RepRapLtd/AnalogueNeuralNet/Electronics/gpt4-maybe-halucinating.odt

To set up the AD5628 DAC for operation and ensure you can use Command 0x03 to write voltages directly to all eight channels, you’ll need to configure it properly through SPI. The AD5628 accepts 32-bit data packets with each packet structured as follows:

1. Control Bits (4 bits): These specify the command or operation.
2. Address Bits (4 bits): These specify the DAC channel (or channels, in the case of broadcast and other functions) being addressed.
3. Data Bits (24 bits): These carry the actual data for the DAC to convert or use in other operations.

Here is the recommended sequence of commands to set up the AD5628 for subsequent use with command 0x03 to directly write voltages:

### 1. Reset the Device

Before any configuration, it’s good practice to reset the DAC:

- Command (4 bits): 0x04 (Reset command)
- Address (4 bits): 0xF (all channels)
- Data (24 bits): All zeros 0x000000

SPI Packet: 0x4F000000

### 2. Power-Up All DACs

You might want to ensure all DAC channels are powered up:

- Command (4 bits): 0x02 (Power up/down)
- Address (4 bits): 0xF (all channels)
- Data (24 bits): Lower 8 bits set to 0x01 to power up, rest are 0s (0x01 for each channel you want powered up)

SPI Packet: 0x2F000001

### 3. Set Internal Reference (if not using an external reference)

To use the internal reference:

- Command (4 bits): 0x07 (Internal reference setup)
- Address (4 bits): 0xF (all channels)
- Data (24 bits): First bit 1 to enable, rest are 0s

SPI Packet: 0x7F800000

### Using Command 0x03 to Write to DAC Channels

Now that the DAC is configured, you can write voltages to any of the eight channels using command 0x03:

- Command (4 bits): 0x03 (Write and update DAC channel)
- Address (4 bits): 0xX (choose from 0 to 7 to specify the channel)
- Data (24 bits): Data to be written to the specified DAC

SPI Packet Example (writing to channel 0):

- Data: 0x03, Address: 0x0, Data: Let's say half-scale (0x7FFFFF for 24-bit DAC)
- SPI Packet: 0x3007FFFF

For each channel, adjust the address bits accordingly (0x0 to 0x7) and specify your desired output value in the data field. Remember, the data resolution and reference voltage determine the output voltage value.

Always ensure that your SPI settings (clock polarity, phase, and maximum frequency) comply with the AD5628 specifications. Also, verify all SPI transactions with oscilloscope traces or logic analyzers to confirm that the timing and data integrity meet the requirements of the AD5628. This methodical setup should ensure smooth operation of the DAC for precision output tasks.
