RepRapLtd/AnalogueNeuralNet/Documents/1.27-socket.pdf

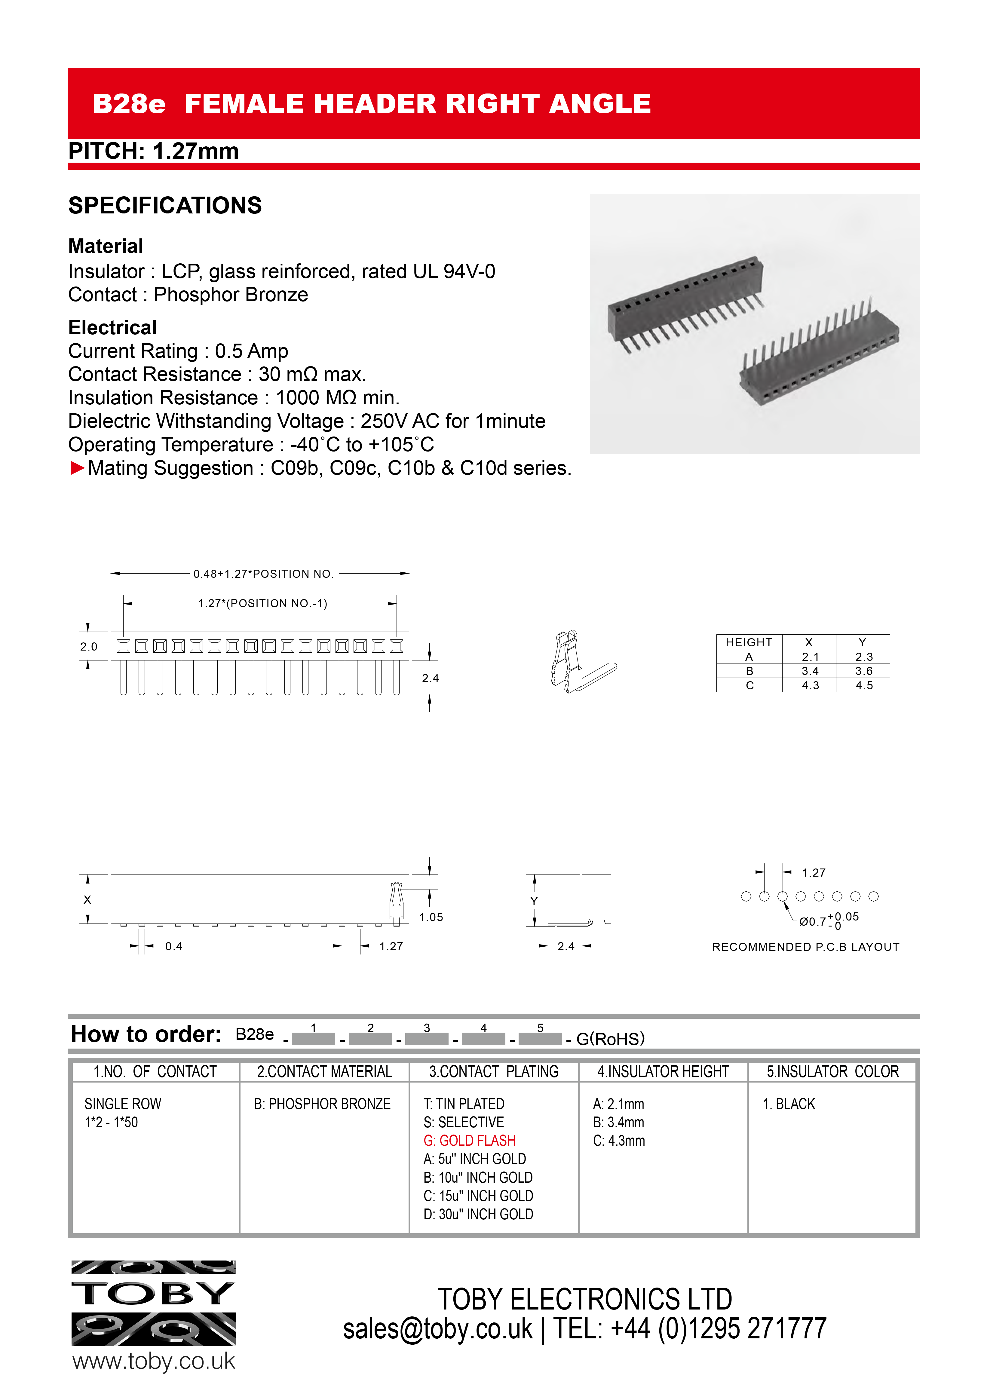
[picture p5: page 1]
