RepRapLtd/AnalogueNeuralNet/Documents/holographic-ann.pdf

© 1990 NaturePublishingGroup

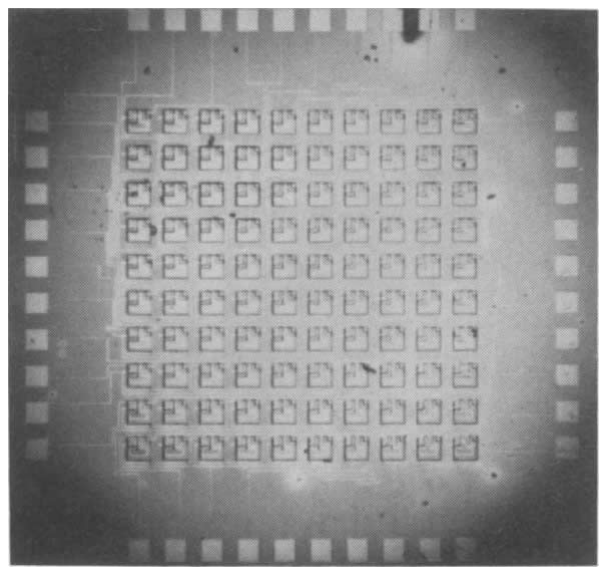
[picture p6: figure]

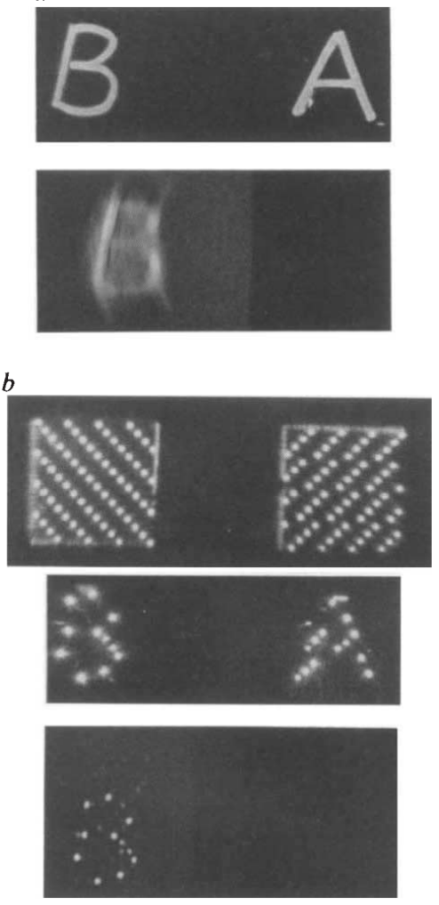
[picture p7: figure]
