RepRapLtd/AnalogueNeuralNet/Electronics/op-amp-bias.ods

r1 | 330
r2 | 182.032258064516
lpr | 33
v | 1.3671875
Vcc | 5
 | 1.3671875
