RepRapLtd/AnalogueNeuralNet/Electronics/one-synapse-electronic-A/one-synapse-electronic/one-synapse-electronic.ods

 | /home/ensab/Desktop/rrlOwncloud/RepRapLtd/Engineering/Internal-Projects/AnalogueNeuralNet/Electronics/one-synapse-electronic/one-synapse-electronic/one-synapse-electronic.kicad_sch
Date: | Fri Nov 10 15:12:36 2023
Tool: | Eeschema 7.0.8-7.0.8~ubuntu20.04.1
Generator: | /usr/share/kicad/plugins/bom_csv_grouped_by_value.py
Component Count: | 141
Collated Components:
Item | Qty | Value | LibPart | Footprint | Datasheet | DNP
1 | 6 | 0.1uF | Device:C | Capacitor_SMD:C_0805_2012Metric | ~
2 | 16 | 120nF | Device:C | Capacitor_SMD:C_0805_2012Metric | ~
3 | 1 | 10uF | Device:C_Polarized | Capacitor_THT:CP_Radial_D8.0mm_P2.50mm | ~
4 | 1 | LED | Device:LED | LED_SMD:LED_0805_2012Metric_Pad1.15x1.40mm_HandSolder | ~
5 | 4 | MountingHole | Mechanical:MountingHole | MountingHole:MountingHole_2.5mm | ~
6 | 1 | prg-err | Connector:Conn_01x02_Pin | Connector_PinHeader_2.54mm:PinHeader_1x02_P2.54mm_Vertical | ~
7 | 2 | Axon | Connector:Conn_01x08_Socket | Connector_PinSocket_2.54mm:PinSocket_1x08_P2.54mm_Vertical | ~
8 | 1 | PWM-in | Connector:Conn_01x07_Pin | Connector_PinHeader_2.54mm:PinHeader_1x07_P2.54mm_Horizontal | ~
9 | 1 | PWM-out | Connector:Conn_01x07_Socket | Connector_PinSocket_2.54mm:PinSocket_1x07_P2.54mm_Horizontal | ~
10 | 1 | pwr | Connector:Conn_01x02_Pin | Connector_PinHeader_2.54mm:PinHeader_1x02_P2.54mm_Vertical | ~
11 | 1 | synapses | Connector:Conn_01x08_Socket | Connector_PinHeader_2.54mm:PinHeader_1x08_P2.54mm_Vertical | ~
12 | 1 | sel | Connector:Conn_01x04_Socket | Connector_PinSocket_2.54mm:PinSocket_1x04_P2.54mm_Vertical | ~
13 | 1 | comb | Connector:Conn_01x03_Socket | Connector_PinSocket_2.54mm:PinSocket_1x03_P2.54mm_Vertical | ~
14 | 1 | sj | Jumper:SolderJumper_2_Bridged | Jumper:SolderJumper-2_P1.3mm_Bridged2Bar_Pad1.0x1.5mm | ~
15 | 17 | BS170F | Transistor_FET:BS170F | Package_TO_SOT_SMD:SOT-23 | http://www.diodes.com/assets/Datasheets/BS170F.pdf
16 | 1 | 2K2 | Device:R | Resistor_SMD:R_0805_2012Metric | ~
17 | 16 | 47K | Device:R | Resistor_SMD:R_0805_2012Metric | ~
18 | 9 | 10K | Device:R | Resistor_SMD:R_0805_2012Metric | ~
19 | 8 | 1M | Device:R | Resistor_SMD:R_0805_2012Metric | ~
20 | 17 | 220R | Device:R | Resistor_SMD:R_0805_2012Metric | ~
21 | 9 | 22K | Device:R | Resistor_SMD:R_0805_2012Metric | ~
22 | 8 | 470K | Device:R | Resistor_SMD:R_0805_2012Metric | ~
23 | 10 | 220K | Device:R | Resistor_SMD:R_0805_2012Metric | ~
24 | 2 | 100K | Device:R | Resistor_SMD:R_0805_2012Metric | ~
25 | 1 | TLC5940PWP | Driver_LED:TLC5940PWP | Package_SO:HTSSOP-28-1EP_4.4x9.7mm_P0.65mm_EP3.4x9.5mm_Mask2.4x6.17mm_ThermalVias | http://www.ti.com/lit/ds/symlink/tlc5940.pdf
26 | 5 | MCP6004 | Amplifier_Operational:MCP6004 | Package_SO:HTSSOP-14-1EP_4.4x5mm_P0.65mm_EP3.4x5mm_Mask3x3.1mm | http://ww1.microchip.com/downloads/en/DeviceDoc/21733j.pdf
