RepRapLtd/AnalogueNeuralNet/Electronics/Kicad/ADG2188BCPZ-REEL7.step

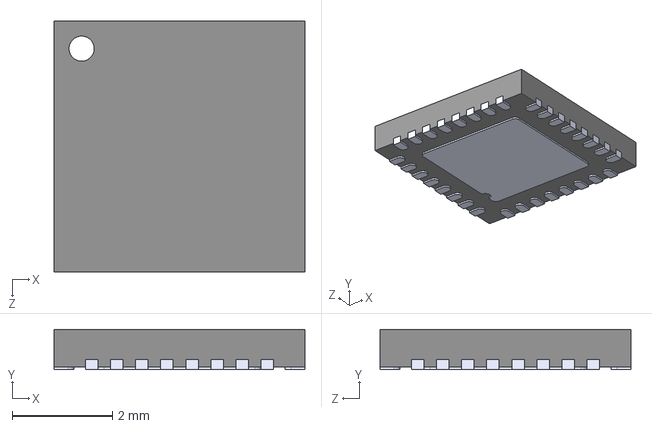
[picture p8: CAD file, 2024-05-18]
Electronics/Kicad/ADG2188BCPZ-REEL7.step
5.00 x 0.8 x 5.00 mm
