RepRapLtd/AnalogueNeuralNet/Mechanics/laser-dot-test.dxf

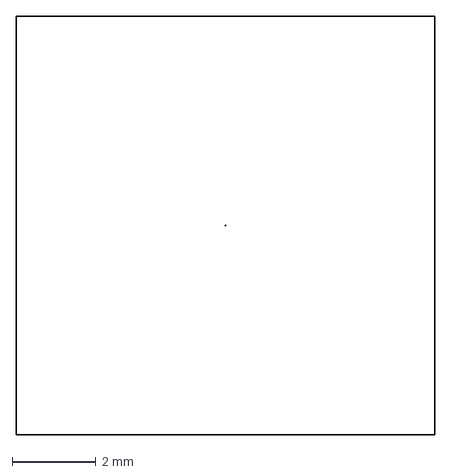
[picture p9: CAD file, 2021-03-25]
Mechanics/laser-dot-test.dxf
10.0 x 10.0 mm
