RepRapLtd/AnalogueNeuralNet/Mechanics/STL/Painting Jig 0.1.stl

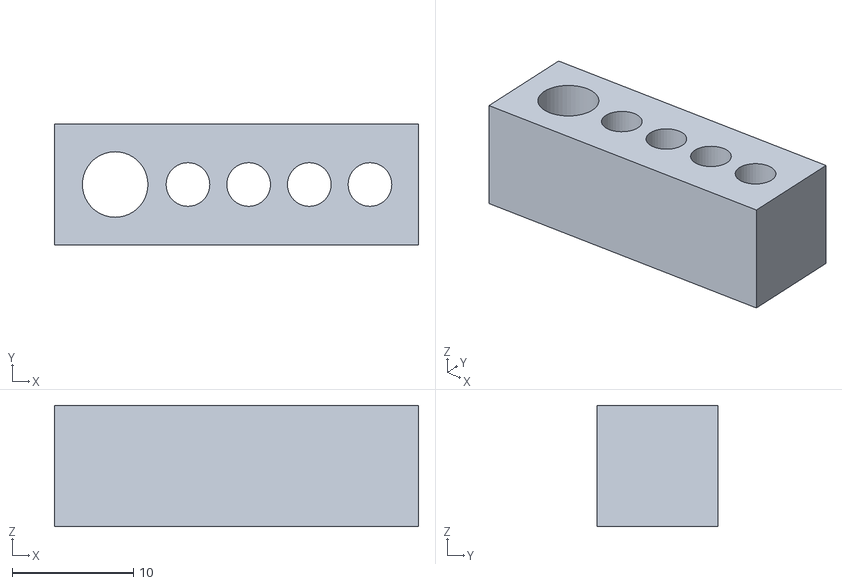
[picture p10: CAD file, 2020-11-20]
Mechanics/STL/Painting Jig 0.1.stl
30.0 x 10.0 x 10.0
