RepRapLtd/AnalogueNeuralNet/Optics/laser-rectangle-100x20.dxf

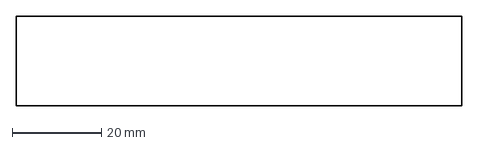
[picture p11: CAD file, 2021-03-05]
Optics/laser-rectangle-100x20.dxf
100.0 x 20.0 mm
