RepRapLtd/AnalogueNeuralNet/Mechanics/integrated-neuron-0.2.FCStd

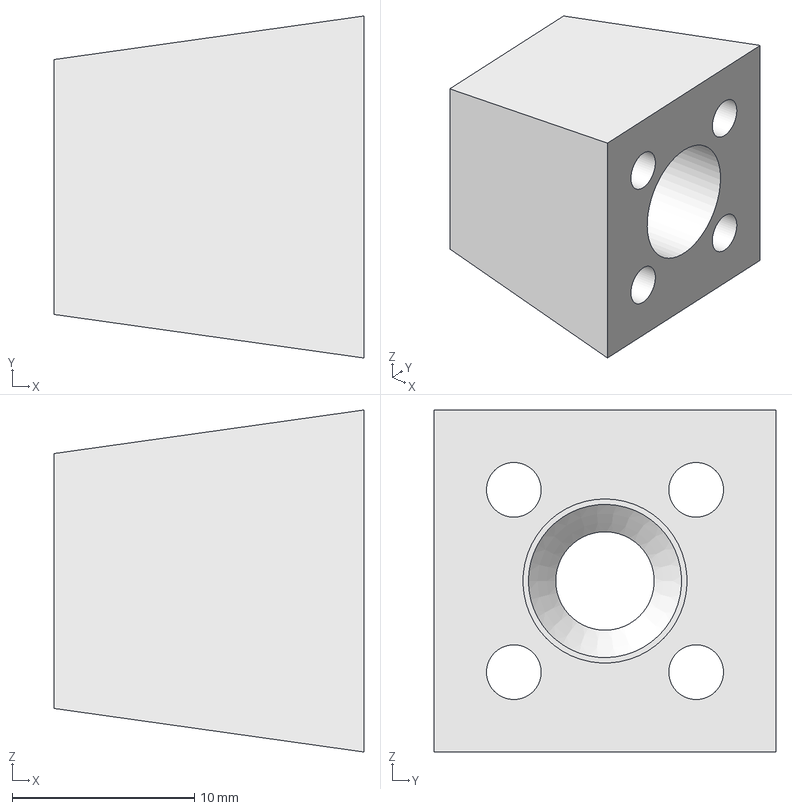
[picture p12: CAD file, 2021-01-26]
Mechanics/integrated-neuron-0.2.FCStd
17.0 x 18.8 x 18.8 mm
