RepRapLtd/AnalogueNeuralNet/Mechanics/STL/integrated-neuron-output.stl

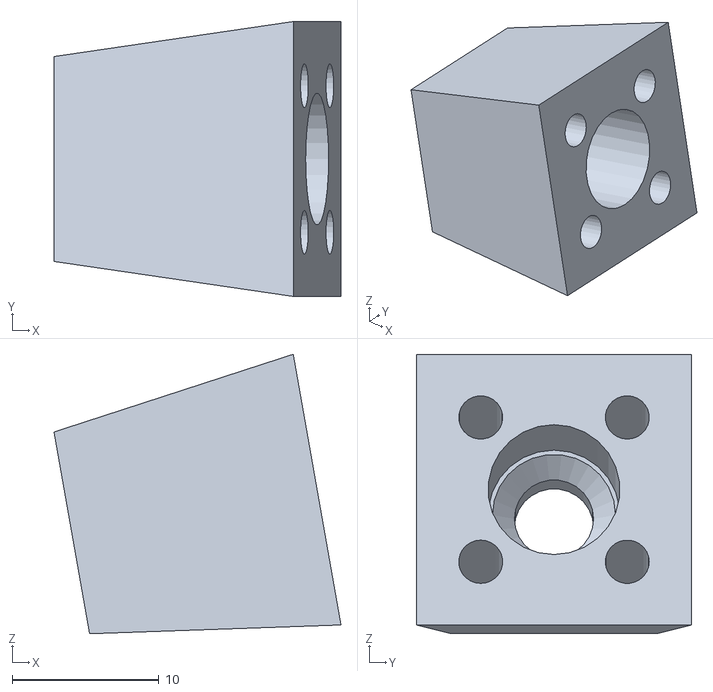
[picture p13: CAD file, 2020-11-06]
Mechanics/STL/integrated-neuron-output.stl
19.6 x 18.8 x 19.1
