RepRapLtd/AnalogueNeuralNet/Mechanics/Crude Image Sensor Array 0.1.FCStd

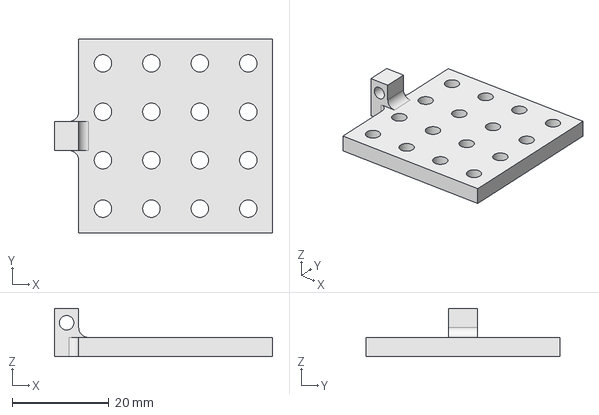
[picture p14: CAD file, 2020-12-15]
Mechanics/Crude Image Sensor Array 0.1.FCStd
45.0 x 40.0 x 10.0 mm
