RepRapLtd/AnalogueNeuralNet/Mechanics/STL/integrated-neuron-fibres.stl

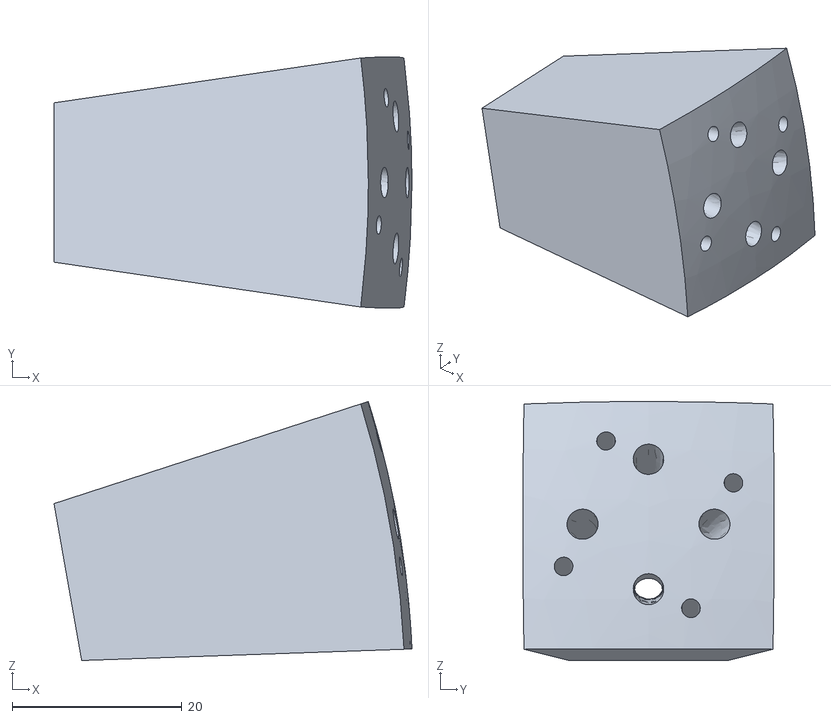
[picture p15: CAD file, 2020-11-06]
Mechanics/STL/integrated-neuron-fibres.stl
42.2 x 29.6 x 30.5
