RepRapLtd/AnalogueNeuralNet/Mechanics/neuron-diagram.dxf

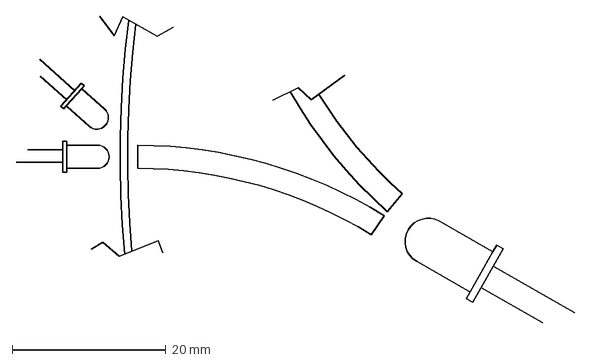
[picture p16: CAD file, 2020-11-27]
Mechanics/neuron-diagram.dxf
72.7 x 39.9 mm
