RepRapLtd/AnalogueNeuralNet/Mechanics/STL/integrated-neuron-input.stl

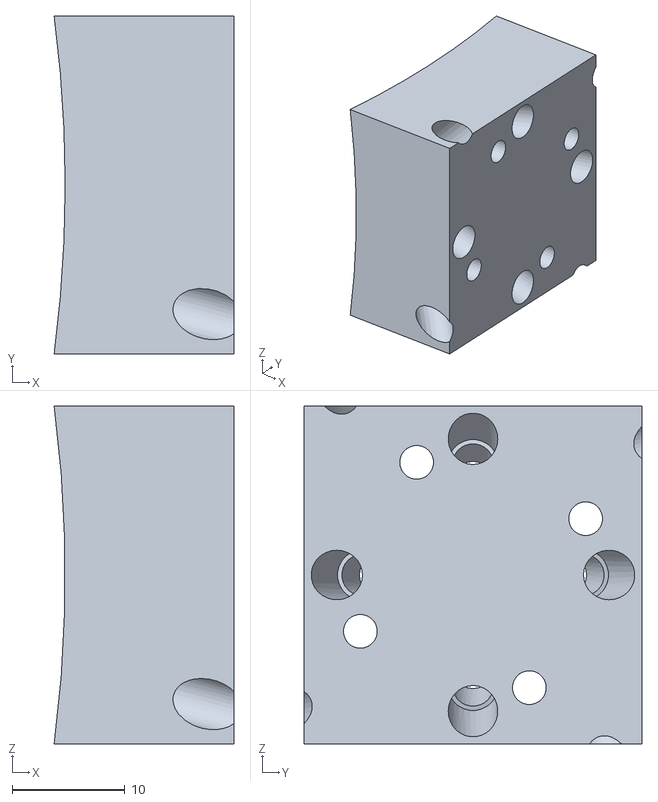
[picture p17: CAD file, 2020-11-06]
Mechanics/STL/integrated-neuron-input.stl
16.0 x 30.0 x 30.0
