RepRapLtd/AnalogueNeuralNet/Mechanics/Painting Jig 0.2 (ultimaker).FCStd

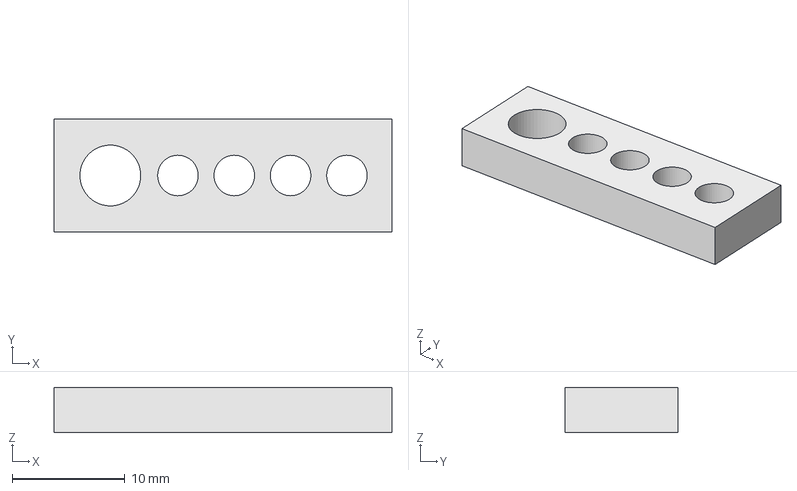
[picture p18: CAD file, 2020-11-26]
Mechanics/Painting Jig 0.2 (ultimaker).FCStd
30.0 x 10.0 x 4.00 mm
