RepRapLtd/AnalogueNeuralNet/Mechanics/STL/light-input.stl

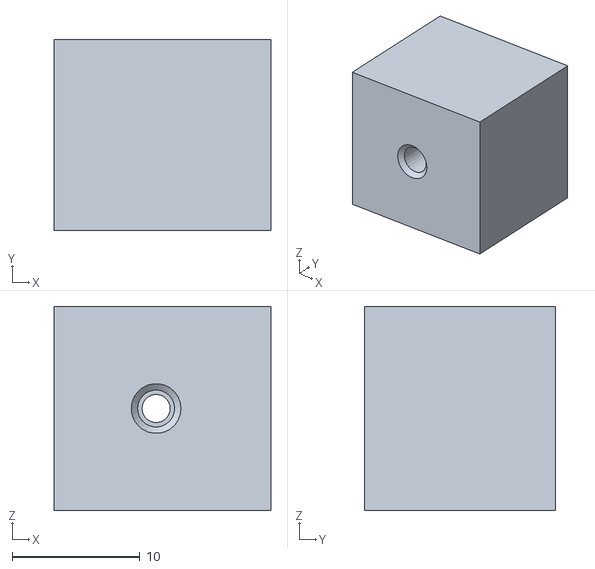
[picture p19: CAD file, 2020-10-22]
Mechanics/STL/light-input.stl
17.0 x 15.0 x 16.0
