RepRapLtd/AnalogueNeuralNet/Mechanics/Sanding Disc 0.1.FCStd

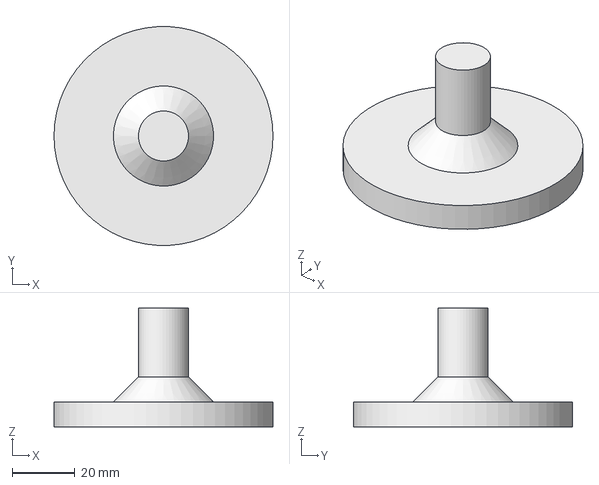
[picture p20: CAD file, 2020-11-24]
Mechanics/Sanding Disc 0.1.FCStd
70.0 x 69.9 x 38.0 mm
