RepRapLtd/AnalogueNeuralNet/Mechanics/STL/synapse.stl

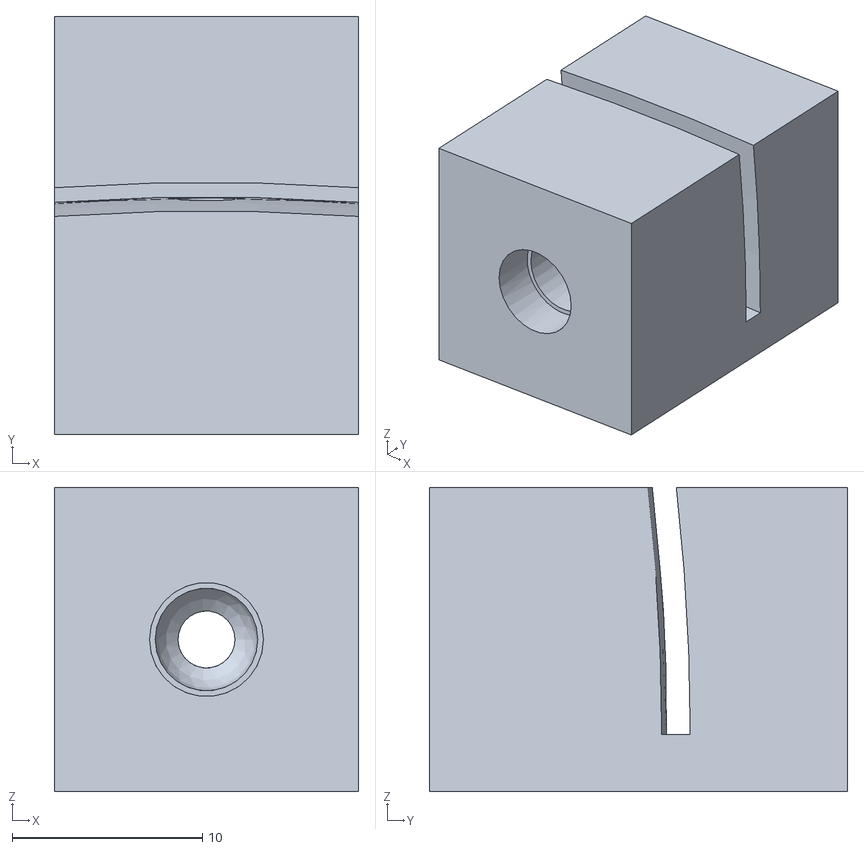
[picture p21: CAD file, 2020-10-21]
Mechanics/STL/synapse.stl
16.0 x 22.0 x 16.0
