RepRapLtd/AnalogueNeuralNet/Mechanics/Painting Jig 0.1 (Fisher).FCStd

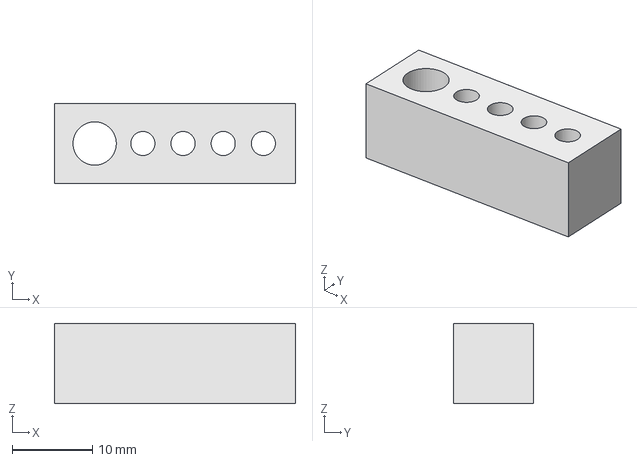
[picture p22: CAD file, 2020-11-24]
Mechanics/Painting Jig 0.1 (Fisher).FCStd
30.0 x 10.0 x 10.0 mm
