RepRapLtd/AnalogueNeuralNet/Mechanics/integrated-neuron-0.1.FCStd

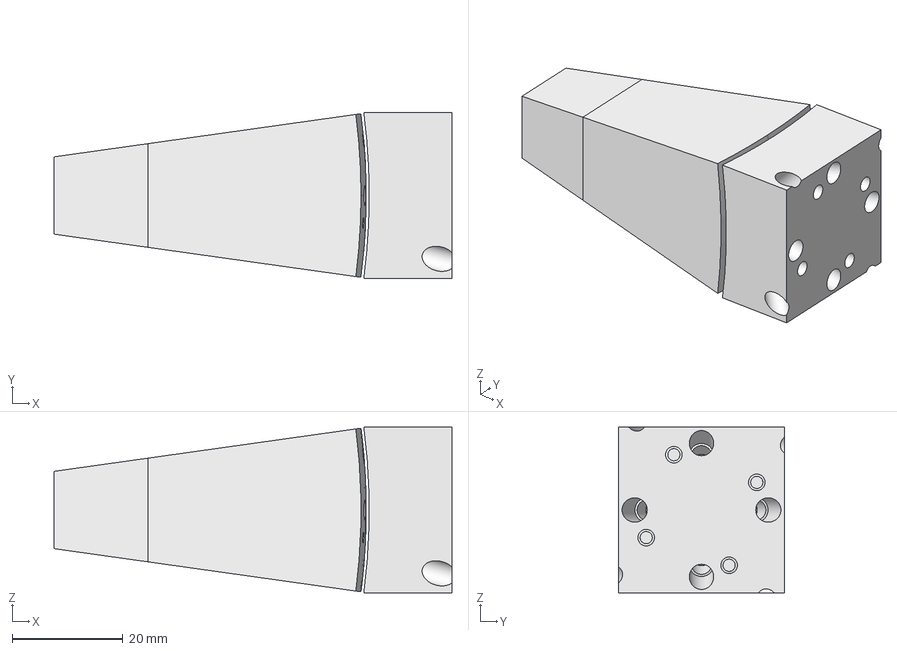
[picture p23: CAD file, 2020-11-06]
Mechanics/integrated-neuron-0.1.FCStd
72.0 x 30.0 x 30.0 mm
light-fibres
input
output
