RepRapLtd/AnalogueNeuralNet/Mechanics/Synapse 2 Small LED 0.1.FCStd

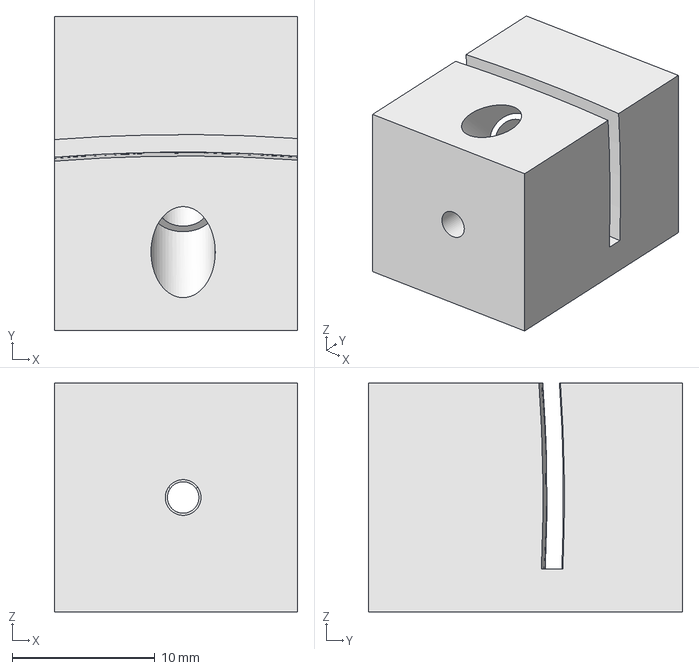
[picture p24: CAD file, 2020-11-03]
Mechanics/Synapse 2 Small LED 0.1.FCStd
17.0 x 22.0 x 16.0 mm
