RepRapLtd/AnalogueNeuralNet/Mechanics/Light Input 0.2.FCStd

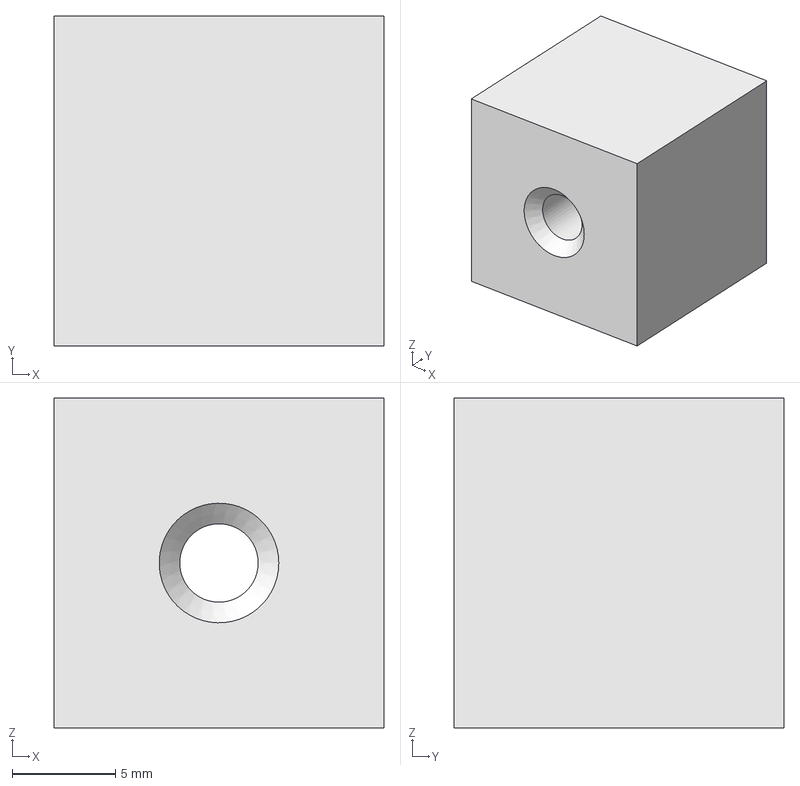
[picture p25: CAD file, 2020-11-03]
Mechanics/Light Input 0.2.FCStd
16.0 x 16.0 x 16.0 mm
