RepRapLtd/AnalogueNeuralNet/Mechanics/Multi Input Synapse 0.1.FCStd

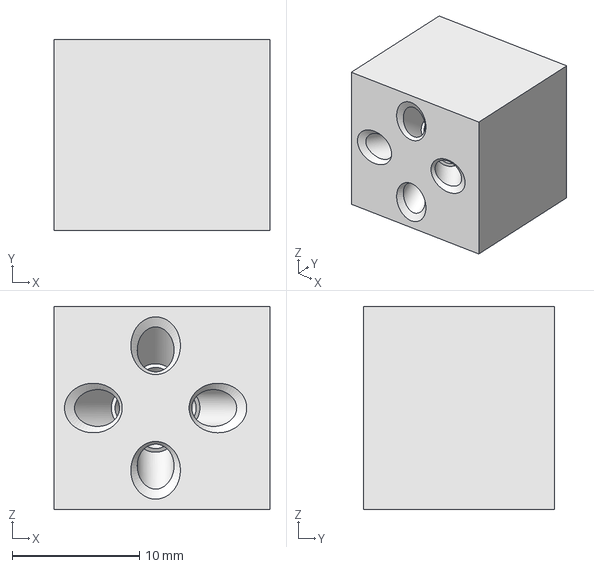
[picture p26: CAD file, 2020-10-22]
Mechanics/Multi Input Synapse 0.1.FCStd
17.0 x 15.0 x 16.0 mm
