RepRapLtd/AnalogueNeuralNet/Mechanics/Synapse 2 0.1.FCStd

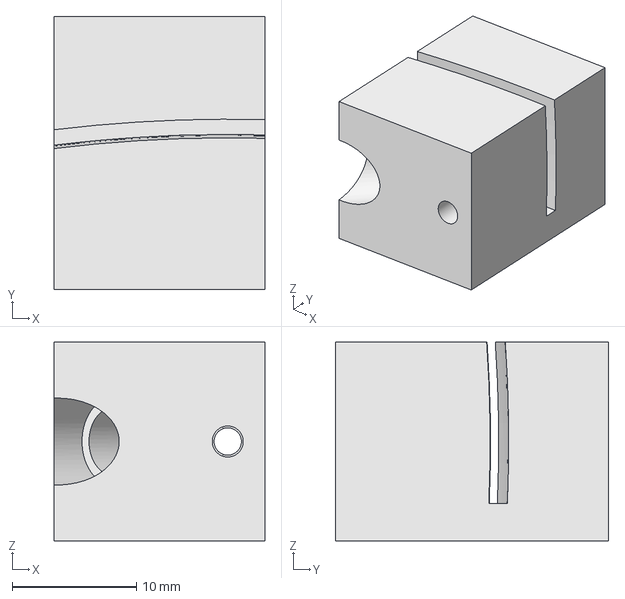
[picture p27: CAD file, 2020-10-22]
Mechanics/Synapse 2 0.1.FCStd
17.0 x 22.0 x 16.0 mm
