RepRapLtd/AnalogueNeuralNet/(list of files, cad)

Other CAD files:
Mechanics/Painting Jig 0.1 (ultimaker).FCStd
Mechanics/Synapse 2 Small LED 0.2.FCStd
Mechanics/Light Input 0.1.FCStd
Mechanics/single-synapse.FCStd
Mechanics/STL/Crude Image Sensor Array 0.1.stl
Mechanics/STL/Light Input 0.2.stl
Mechanics/STL/Multi Input Synapse 0.1.stl
Mechanics/STL/Painting Jig 0.2(Ultimaker).stl
Mechanics/STL/Sanding Disc 0.1.stl
Mechanics/STL/Synapse 2 0.1.stl
Mechanics/STL/Synapse 2 Small LED 0.1.stl
Mechanics/STL/Synapse 2 Small LED 0.2.stl
