RepRapLtd/AnalogueNeuralNet/Experiments/first-teaching-results.txt

Seems to be oscillating...

RepRap Ltd Optical Half-Neuron Starting
2 mins
0.37, 19, 21, 24, 24, 2, -3, 2, -3
0.37, 21, 18, 26, 21, -5, 7, -5, 7
0.25, 16, 25, 21, 28, 19, -28, 19, -28
0.37, 35, 0, 40, 0, -51, 66, -51, 74
0.19, 0, 66, 0, 74, 186, -352, 212, -395
