RepRapLtd/AnalogueNeuralNet/Experiments/MCP604-driving-LED.ods

Vin | Vout | Iout (mA)
0 | 0.1 | 0
1.67 | 1.648 | 0.01
1.81 | 1.789 | 0.09
1.85 | 1.828 | 0.15
1.95 | 1.926 | 0.39
2.07 | 2.052 | 0.79
2.2 | 2.179 | 1.25
2.31 | 2.286 | 1.65
2.42 | 2.4 | 2.09
2.63 | 2.607 | 2.89
2.79 | 2.765 | 3.53
3.02 | 2.992 | 4.46
3.24 | 3.206 | 5.33
3.61 | 3.58 | 6.88
3.93 | 3.89 | 8.17
4.32 | 4.27 | 9.79
4.56 | 4.51 | 10.8
4.88 | 4.83 | 12.16
4.94 | 5.5 | 12.4
