RepRapLtd/AnalogueNeuralNet/Experiments/Driven-LED-calibration.ods

PWM | 300, 1ms | 1000,1ms | 100,1ms | 100,0ms | bias resistors; no fibre
0 | 5 | 5 | 5 | 5 | 5
1 | 4.99 | 4.99 | 5 | 5 | 5
2 | 5 | 4.99 | 5 | 5 | 5
3 | 5 | 5 | 5 | 5 | 4.99
4 | 5 | 5 | 5 | 5 | 5
5 | 5 | 5 | 5 | 4.99 | 5
6 | 5 | 5 | 5 | 5 | 5
7 | 5 | 5 | 5 | 5 | 5
8 | 5 | 5 | 5 | 5 | 5
9 | 5 | 5 | 5 | 5 | 5
10 | 5 | 5 | 5 | 5 | 5
11 | 5 | 5 | 5 | 5 | 5
12 | 5 | 5 | 4.99 | 5 | 4.99
13 | 5 | 5 | 5 | 5 | 4.98
14 | 5 | 5 | 5 | 5 | 4.95
15 | 5 | 5 | 5 | 5 | 4.89
16 | 5 | 5 | 5 | 5 | 4.87
17 | 5 | 5 | 5 | 5 | 4.85
18 | 4.99 | 5 | 5 | 5 | 4.83
19 | 5 | 5 | 5 | 4.99 | 4.81
20 | 4.99 | 5 | 5 | 5 | 4.79
21 | 5 | 5 | 5 | 5 | 4.77
22 | 5 | 5 | 5 | 5 | 4.74
23 | 5 | 5 | 5 | 4.99 | 4.73
24 | 5 | 5 | 5 | 5 | 4.71
25 | 5 | 5 | 5 | 5 | 4.69
26 | 5 | 5 | 5 | 5 | 4.67
27 | 5 | 5 | 5 | 5 | 4.65
28 | 5 | 5 | 5 | 4.99 | 4.63
29 | 4.99 | 5 | 5 | 5 | 4.61
30 | 5 | 5 | 4.99 | 5 | 4.59
31 | 5 | 5 | 5 | 5 | 4.57
32 | 5 | 5 | 5 | 5 | 4.55
33 | 5 | 5 | 5 | 5 | 4.52
34 | 5 | 5 | 5 | 4.99 | 4.51
35 | 5 | 5 | 5 | 5 | 4.49
36 | 5 | 5 | 5 | 5 | 4.46
37 | 5 | 5 | 5 | 5 | 4.44
38 | 5 | 5 | 5 | 5 | 4.42
39 | 5 | 5 | 5 | 5 | 4.4
40 | 5 | 5 | 5 | 5 | 4.37
41 | 5 | 5 | 5 | 5 | 4.36
42 | 5 | 5 | 5 | 5 | 4.33
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
