RepRapLtd/AnalogueNeuralNet/Experiments/half-neuron-calibration.ods

Sheet: real-half-neuron-calibration
 | PWM |  |  |  | 0 | 1 | 2 | 3 | 4 | 5 | 6 | 7 | 8 | 9 | 10 | 11 | 12 | 13 | 14 | 15 | simulation | 1 | 2 | 4 | 8
0 | 0 | 0 | 0 | 0 | 5 | 4.38 | 4.27 | 3.63 | 4.53 | 3.89 | 3.77 | 3.12 | 4.46 | 3.82 | 3.71 | 3.06 | 3.98 | 3.33 | 3.21 | 2.55 | 2.6 | 4.38 | 4.27 | 4.53 | 4.46
1 | 17 | 0 | 0 | 0 | 5 | 4.62 | 4.27 | 3.87 | 4.53 | 4.13 | 3.77 | 3.37 | 4.46 | 4.06 | 3.71 | 3.3 | 3.98 | 3.57 | 3.21 | 2.8 | 2.84 | 4.62 | 4.51 | 4.63 | 4.62
2 | 34 | 0 | 0 | 0 | 5 | 4.68 | 4.27 | 3.94 | 4.53 | 4.19 | 3.77 | 3.43 | 4.46 | 4.13 | 3.71 | 3.36 | 3.98 | 3.64 | 3.21 | 2.87 | 2.9 | 4.68 | 4.58 | 4.67 | 4.67
3 | 51 | 0 | 0 | 0 | 5 | 4.71 | 4.27 | 3.96 | 4.53 | 4.22 | 3.77 | 3.46 | 4.46 | 4.16 | 3.71 | 3.4 | 3.98 | 3.67 | 3.21 | 2.9 | 2.93 | 4.71 | 4.62 | 4.71 | 4.7
4 | 68 | 0 | 0 | 0 | 5 | 4.73 | 4.27 | 3.98 | 4.53 | 4.24 | 3.77 | 3.48 | 4.46 | 4.18 | 3.71 | 3.41 | 3.98 | 3.69 | 3.21 | 2.92 | 2.95 | 4.73 | 4.64 | 4.72 | 4.71
5 | 85 | 0 | 0 | 0 | 5 | 4.74 | 4.27 | 3.99 | 4.53 | 4.25 | 3.77 | 3.49 | 4.46 | 4.19 | 3.71 | 3.43 | 3.98 | 3.7 | 3.21 | 2.93 | 2.96 | 4.74 | 4.66 | 4.74 | 4.73
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
