RepRapLtd/AnalogueNeuralNet/Experiments/pwm-test.ods

seconds | PWM=63 | PWM=127 | PWM=191 | PWM=255
1 | 3.24 | 3.22 | 3.2 | 3.15
2 | 3.24 | 3.2 | 3.2 | 3.15
3 | 3.24 | 3.24 | 3.24 | 3.2
4 | 3.25 | 3.26 | 3.27 | 3.26
5 | 3.26 | 3.29 | 3.33 | 3.31
6 | 3.27 | 3.32 | 3.35 | 3.36
7 | 3.29 | 3.34 | 3.39 | 3.4
8 | 3.3 | 3.37 | 3.42 | 3.44
9 | 3.32 | 3.39 | 3.46 | 3.48
10 | 3.33 | 3.41 | 3.48 | 3.51
11 | 3.34 | 3.43 | 3.51 | 3.54
12 | 3.35 | 3.45 | 3.54 | 3.56
13 | 3.36 | 3.46 | 3.55 | 3.59
14 | 3.37 | 3.49 | 3.58 | 3.61
15 | 3.39 | 3.51 | 3.6 | 3.63
16 | 3.4 | 3.52 | 3.61 | 3.66
17 | 3.41 | 3.54 | 3.64 | 3.67
18 | 3.42 | 3.55 | 3.65 | 3.69
19 | 3.43 | 3.57 | 3.67 | 3.71
20 | 3.43 | 3.57 | 3.68 | 3.73
21 | 3.45 | 3.59 | 3.7 | 3.74
22 | 3.45 | 3.6 | 3.71 | 3.75
23 | 3.47 | 3.61 | 3.72 | 3.76
24 | 3.47 | 3.62 | 3.74 | 3.77
25 | 3.48 | 3.63 | 3.75 | 3.78
26 | 3.49 | 3.65 | 3.76 | 3.79
27 | 3.49 | 3.65 | 3.76 | 3.81
28 | 3.5 | 3.66 | 3.77 | 3.81
29 | 3.52 | 3.67 | 3.78 | 3.83
30 | 3.53 | 3.68 | 3.79 | 3.83
31 | 3.53 | 3.69 | 3.8 | 3.84
32 | 3.54 | 3.7 | 3.81 | 3.85
33 | 3.54 | 3.71 | 3.82 | 3.86
34 | 3.56 | 3.71 | 3.83 | 3.86
35 | 3.55 | 3.73 | 3.84 | 3.87
36 | 3.56 | 3.73 | 3.84 | 3.87
37 | 3.56 | 3.75 | 3.84 | 3.88
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
