RepRapLtd/AnalogueNeuralNet/Experiments/half-neuron-individual-input-characteristics.png

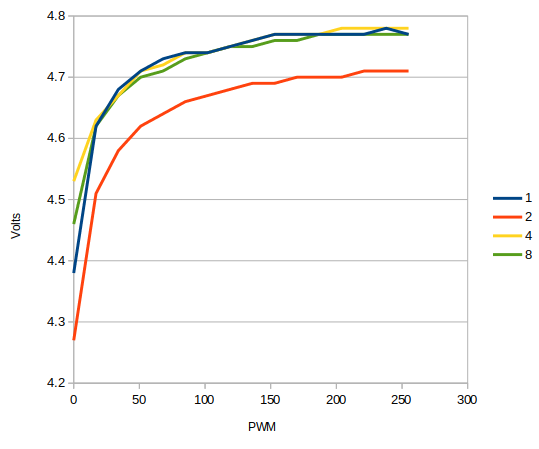
Experiments/half-neuron-individual-input-characteristics.png
