RepRapLtd/AnalogueNeuralNet/Experiments/on-off-response.png

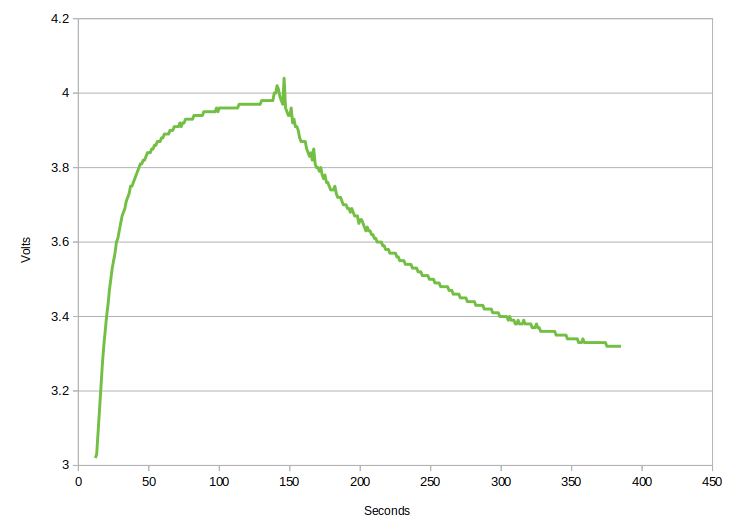
Experiments/on-off-response.png
