RepRapLtd/AnalogueNeuralNet/Electronics/one-synapse-electronic-B/one-synapse-electronic-B/universal-building-block.pdf

R12 R1

# GND GND

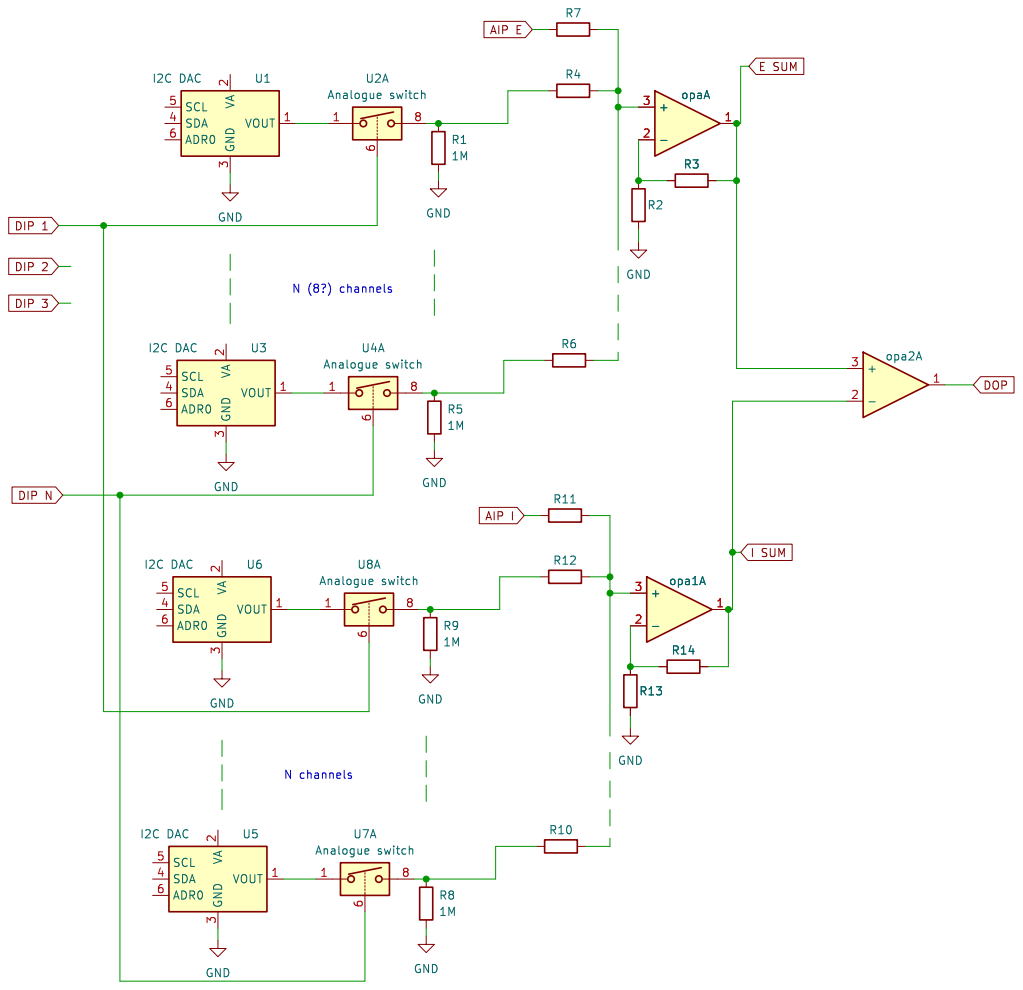
[picture p30: page 1]
