RepRapLtd/AnalogueNeuralNet/Documents/SparkFun-TLC5940-Breakout-v12.pdf

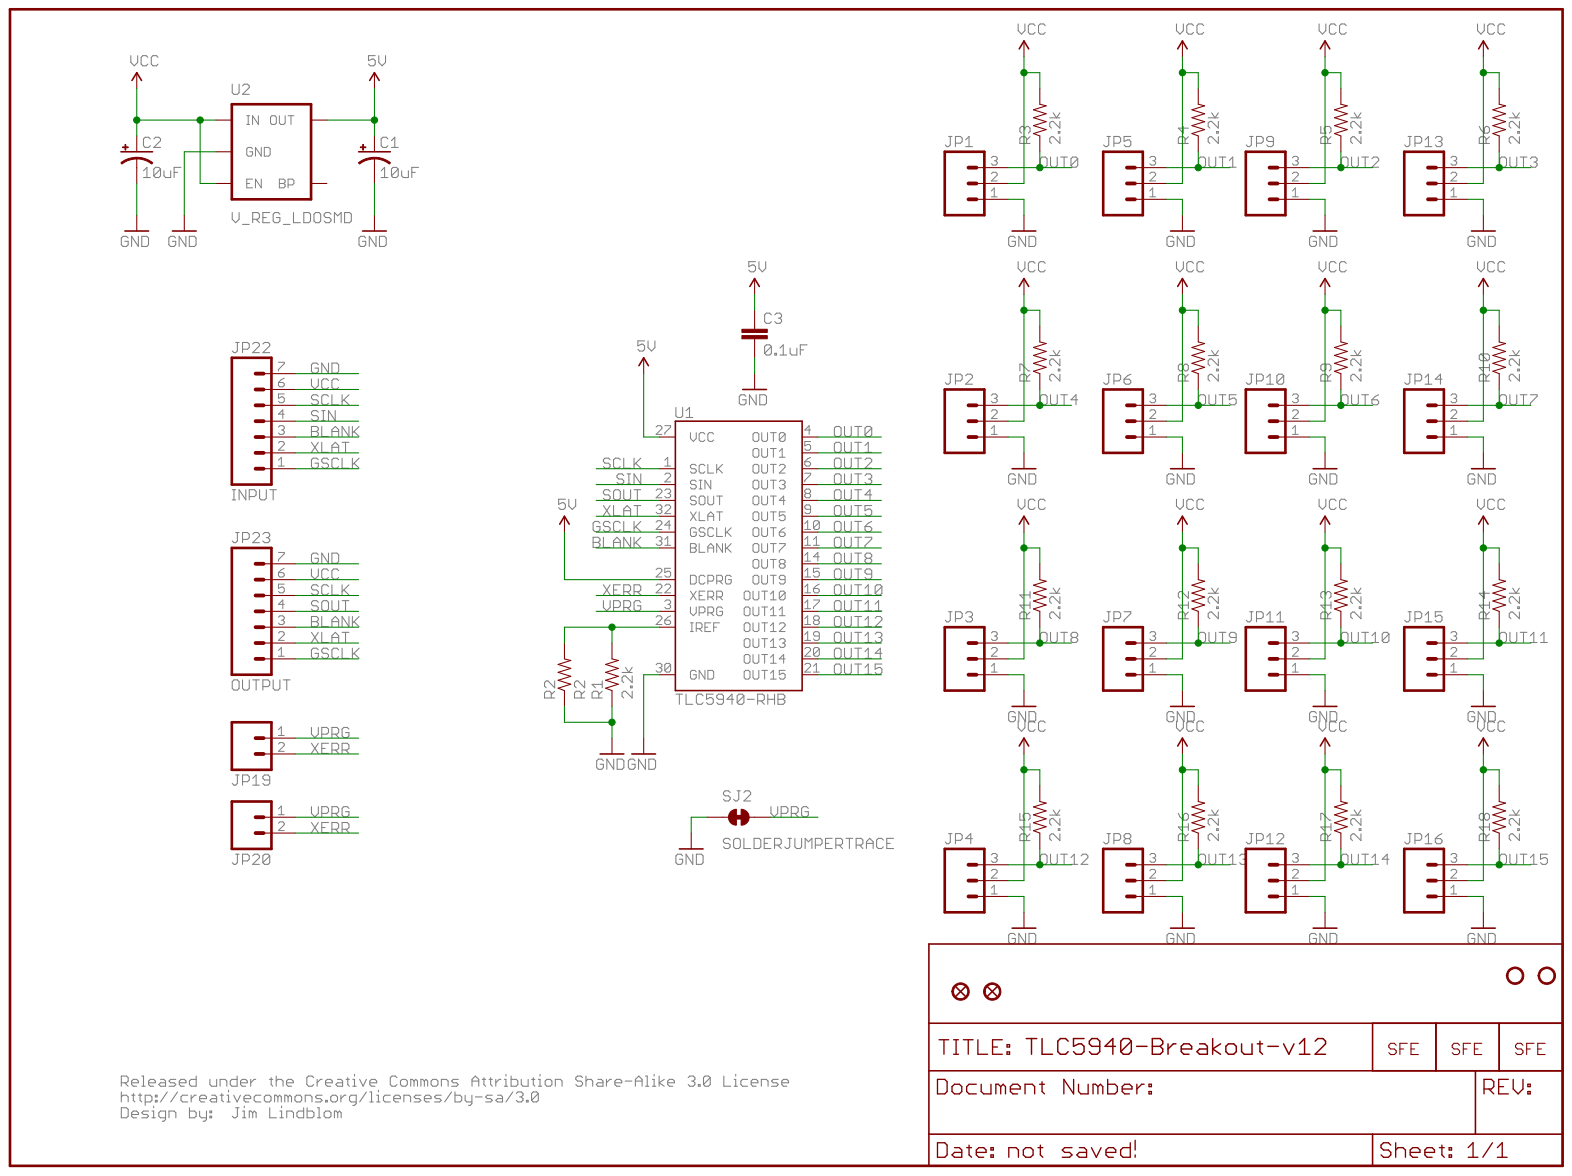
[picture p31: page 1]
