RepRapLtd/AnalogueNeuralNet/Electronics/one-synapse-electronic-B/one-synapse-electronic-B/skidl-experiment/skidl-experiment.kicad_pcb

## KiCad design Electronics/one-synapse-electronic-B/one-synapse-electronic-B/skidl-experiment/skidl-experiment.kicad_pcb (2024-04-09)

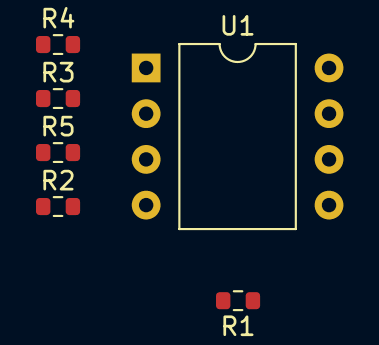
[picture p35: board skidl-experiment.kicad_pcb from above]

Board: 2 copper layers, 6 parts (0 on the bottom side), 2 nets, no tracks yet.

Parts:
R1, R2, R3, R4, R5: 10k; R_0603_1608Metric
U1: LM741; DIP-8_W10.16mm

Connections:
unnamed: R1.2, R2.2, R3.2, R4.2, R5.2, U1.2
Out: R1.1, U1.6
