RepRapLtd/AnalogueNeuralNet/Electronics/one-synapse-electronic-A/one-synapse-electronic/one-synapse-electronic.kicad_pcb

## KiCad design Electronics/one-synapse-electronic-A/one-synapse-electronic/one-synapse-electronic.kicad_pcb (2024-03-20)

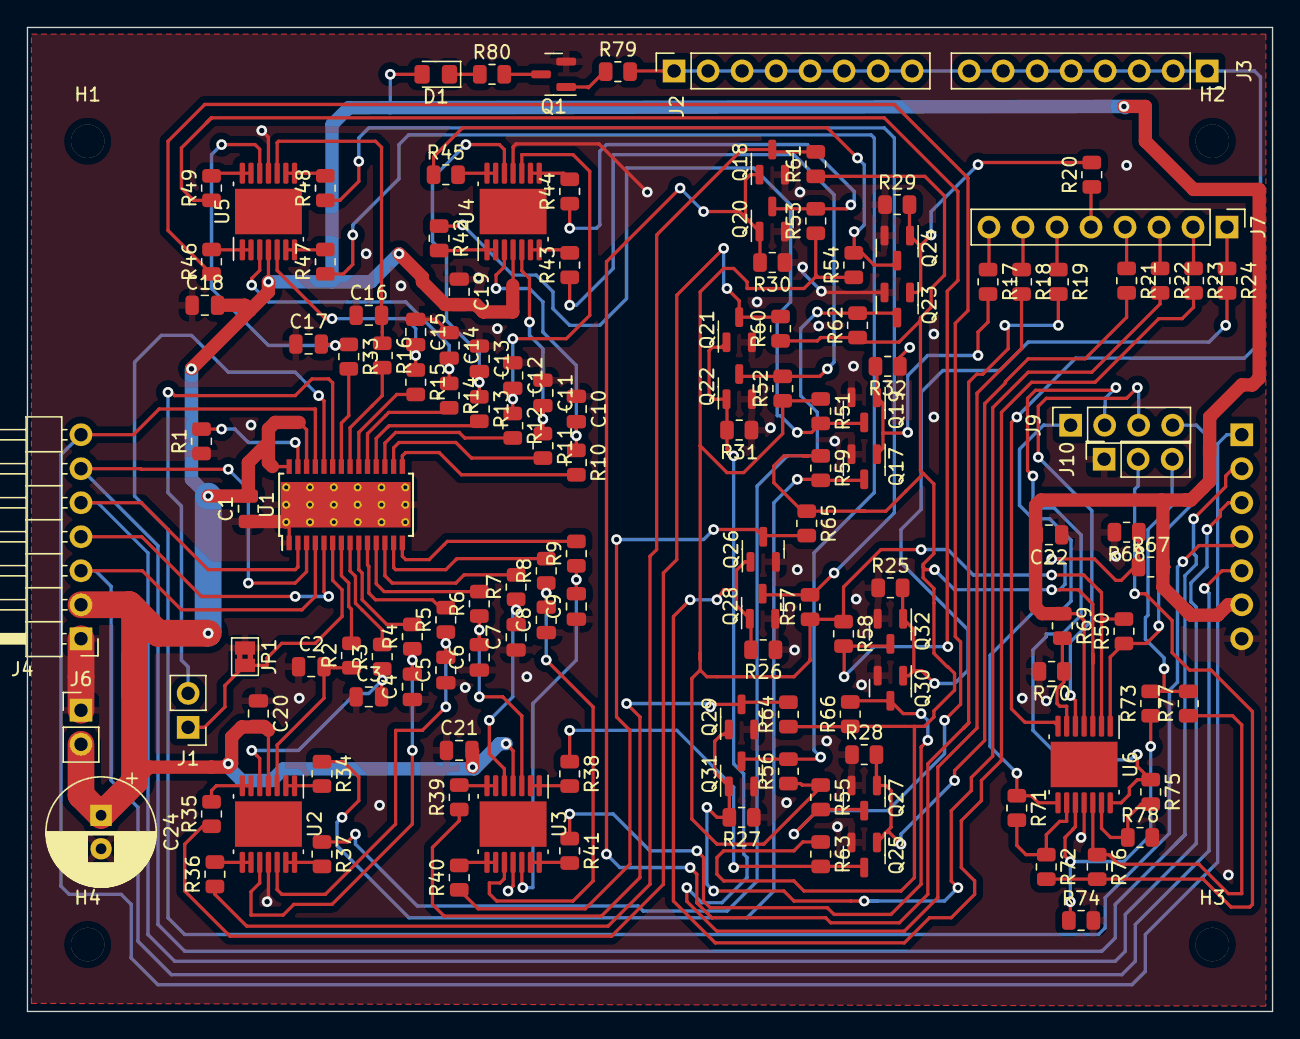
[picture p36: board one-synapse-electronic.kicad_pcb from above]

Board: 2 copper layers, 93.0 x 73.5 mm, 141 parts (1 on the bottom side), 108 nets.

Parts:
C1, C18, C19, C20, C21, C22: 0.1uF; C_0805_2012Metric
C2, C3, C4, C5, C6, C7, C8, C9, C10, C11, C12, C13, C14, C15, C16, C17: 120nF; C_0805_2012Metric
C24: 10uF; CP_Radial_D8.0mm_P2.50mm
D1: LED; LED_0805_2012Metric_Pad1.15x1.40mm_HandSolder
H1, H2, H3, H4: MountingHole; MountingHole_2.5mm
J1: prg-err; PinHeader_1x02_P2.54mm_Vertical
J2, J3: Axon; PinSocket_1x08_P2.54mm_Vertical
J4: PWM-in; PinHeader_1x07_P2.54mm_Horizontal
J5: PWM-out; PinSocket_1x07_P2.54mm_Horizontal
J6: pwr; PinHeader_1x02_P2.54mm_Vertical
J7: synapses; PinHeader_1x08_P2.54mm_Vertical
J9: sel; PinSocket_1x04_P2.54mm_Vertical
J10: comb; PinSocket_1x03_P2.54mm_Vertical
JP1: sj; SolderJumper-2_P1.3mm_Bridged2Bar_Pad1.0x1.5mm
Q1, Q17, Q18, Q19, Q20, Q21, Q22, Q23, Q24, Q25, Q26, Q27, Q28, Q29, Q30, Q31, Q32: BS170F; SOT-23
R1: 2K2; R_0805_2012Metric
R2, R3, R4, R5, R6, R7, R8, R9, R10, R11, R12, R13, R14, R15, R16, R33: 47K; R_0805_2012Metric
R17, R18, R19, R20, R21, R22, R23, R24, R79: 10K; R_0805_2012Metric
R25, R26, R27, R28, R29, R30, R31, R32: 1M; R_0805_2012Metric
R34, R35, R36, R37, R38, R39, R40, R41, R42, R43, R44, R45, R46, R47, R48, R49, R80: 220R; R_0805_2012Metric
R50, R71, R72, R73, R74, R75, R76, R77, R78: 22K; R_0805_2012Metric
R51, R52, R53, R54, R55, R56, R57, R58: 470K; R_0805_2012Metric
R59, R60, R61, R62, R63, R64, R65, R66, R69, R70: 220K; R_0805_2012Metric
R67, R68: 100K; R_0805_2012Metric
U1: TLC5940PWP; HTSSOP-28-1EP_4.4x9.7mm_P0.65mm_EP3.4x9.5mm_Mask2.4x6.17mm_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
U2, U3, U4, U5, U6: MCP6004; HTSSOP-14-1EP_4.4x5mm_P0.65mm_EP3.4x5mm_Mask3x3.1mm

Connections:
B0: Q17.3 (D), R34.1, R59.2
B1: Q21.3 (D), R35.1, R60.2
B2: Q18.3 (D), R36.1, R61.2
B3: Q23.3 (D), R37.1, R62.2
B4: Q25.3 (D), R38.1, R63.2
B5: Q29.3 (D), R39.1, R64.2
B6: Q26.3 (D), R40.1, R65.2
B7: Q30.3 (D), R41.1, R66.2
BLANK: J4.5, J5.3, U1.2 (BLANK)
C0: Q19.3 (D), R42.1, R51.2
C1: Q22.3 (D), R43.1, R52.2
C2: Q20.3 (D), R44.1, R53.2
C3: Q24.3 (D), R45.1, R54.2
C4: Q27.3 (D), R46.1, R55.2
C5: Q31.3 (D), R47.1, R56.2
C6: Q28.3 (D), R48.1, R57.2
C7: Q32.3 (D), R49.1, R58.2
GND: C1.1, C2.1, C3.1, C4.1, C5.1, C6.1, C7.1, C8.1, C9.1, C10.1, C11.1, C12.1, C13.1, C14.1, C15.1, C16.1, C17.1, C18.1, C19.1, C20.1, C21.1, C22.1, C24.2, J4.1, J5.7, J6.1, J10.1, JP1.1 (A), Q1.2 (S), Q17.2 (S), Q18.2 (S), Q19.2 (S), Q20.2 (S), Q21.2 (S), Q22.2 (S), Q23.2 (S), Q24.2 (S), Q25.2 (S), Q26.2 (S), Q27.2 (S), Q28.2 (S), Q29.2 (S), Q30.2 (S), Q31.2 (S), Q32.2 (S), R1.1, R25.1, R26.1, R27.1, R28.1, R29.1, R30.1, R31.1, R32.1, R68.2, R70.2, R74.2, R78.2, U1.1 (GND), U1.29 (PAD), U2.11 (V-), U3.11 (V-), U4.11 (V-), U5.11 (V-), U6.11 (V-)
GSCLK: J4.7, J5.1, U1.25 (GSCLK)
unnamed: D1.1 (K), R80.1
unnamed: J1.1, JP1.2 (B), U1.6 (VPRG)
unnamed: J1.2, U1.23 (XERR)
unnamed: J2.1, J2.2, J2.3, J2.4, J2.5, J2.6, J2.7, J2.8, J3.1, J3.2, J3.3, J3.4, J3.5, J3.6, J3.7, J3.8, R79.2, U6.7
unnamed: J7.1, R24.1
unnamed: J7.2, R23.1
unnamed: J7.3, R22.1
unnamed: J7.4, R21.1
unnamed: J7.5, R20.1
unnamed: J7.6, R19.1
unnamed: J7.7, R18.1
unnamed: J7.8, R17.1
unnamed: J9.1, R71.1, U6.8
unnamed: J9.2, R75.1, U6.14
unnamed: J9.3, U6.5 (+)
unnamed: J9.4, R50.1, U6.1
unnamed: J10.2, R72.2, R76.2
unnamed: J10.3, R73.2, R77.2
unnamed: Q1.3 (D), R80.2
unnamed: Q1.1 (G), R79.1
unnamed: R1.2, U1.27 (IREF)
unnamed: R2.2, U1.7 (OUT0)
unnamed: R3.2, U1.8 (OUT1)
unnamed: R4.2, U1.9 (OUT2)
unnamed: R5.2, U1.10 (OUT3)
unnamed: R6.2, U1.11 (OUT4)
unnamed: R7.2, U1.12 (OUT5)
unnamed: R8.2, U1.13 (OUT6)
unnamed: R9.2, U1.14 (OUT7)
unnamed: R10.2, U1.15 (OUT8)
unnamed: R11.2, U1.16 (OUT9)
unnamed: R12.2, U1.17 (OUT10)
unnamed: R13.2, U1.18 (OUT11)
unnamed: R14.2, U1.19 (OUT12)
unnamed: R15.2, U1.20 (OUT13)
unnamed: R16.2, U1.21 (OUT14)
unnamed: R33.2, U1.22 (OUT15)
unnamed: R34.2, U2.1, U2.2 (-)
unnamed: R35.2, U2.6 (-), U2.7
unnamed: R36.2, U2.8, U2.9 (-)
unnamed: R37.2, U2.13 (-), U2.14
unnamed: R38.2, U3.1, U3.2 (-)
unnamed: R39.2, U3.6 (-), U3.7
unnamed: R40.2, U3.8, U3.9 (-)
unnamed: R41.2, U3.13 (-), U3.14
unnamed: R42.2, U4.1, U4.2 (-)
unnamed: R43.2, U4.6 (-), U4.7
unnamed: R44.2, U4.8, U4.9 (-)
unnamed: R45.2, U4.13 (-), U4.14
unnamed: R46.2, U5.1, U5.2 (-)
unnamed: R47.2, U5.6 (-), U5.7
unnamed: R48.2, U5.8, U5.9 (-)
unnamed: R49.2, U5.13 (-), U5.14
unnamed: R59.1, R60.1, R61.1, R62.1, R63.1, R64.1, R65.1, R66.1, R67.1, R68.1, U6.3 (+)
unnamed: R50.2, R51.1, R52.1, R53.1, R54.1, R55.1, R56.1, R57.1, R58.1, U6.2 (-)
unnamed: R69.2, R70.1, U6.6 (-)
unnamed: R73.1, R74.1, U6.10 (+)
unnamed: R71.2, R72.1, U6.9 (-)
unnamed: R76.1, R77.1, U6.12 (+)
unnamed: R75.2, R78.1, U6.13 (-)
PB0: C2.2, R2.1, U2.3 (+)
PB1: C3.2, R3.1, U2.5 (+)
PB2: C4.2, R4.1, U2.10 (+)
PB3: C5.2, R5.1, U2.12 (+)
PB4: C6.2, R6.1, U3.3 (+)
PB5: C7.2, R7.1, U3.5 (+)
PB6: C8.2, R8.1, U3.10 (+)
PB7: C9.2, R9.1, U3.12 (+)
PC0: C10.2, R10.1, U4.3 (+)
PC1: C11.2, R11.1, U4.5 (+)
PC2: C12.2, R12.1, U4.10 (+)
PC3: C13.2, R13.1, U4.12 (+)
PC4: C14.2, R14.1, U5.3 (+)
PC5: C15.2, R15.1, U5.5 (+)
PC6: C16.2, R16.1, U5.10 (+)
PC7: C17.2, R33.1, U5.12 (+)
S0: Q17.1 (G), Q19.1 (G), R17.2, R32.2
S1: Q21.1 (G), Q22.1 (G), R18.2, R31.2
S2: Q18.1 (G), Q20.1 (G), R19.2, R30.2
S3: Q23.1 (G), Q24.1 (G), R20.2, R29.2
S4: Q25.1 (G), Q27.1 (G), R21.2, R28.2
S5: Q29.1 (G), Q31.1 (G), R22.2, R27.2
S6: Q26.1 (G), Q28.1 (G), R23.2, R26.2
S7: Q30.1 (G), Q32.1 (G), R24.2, R25.2
SCLK: J4.3, J5.5, U1.4 (SCLK)
Sin: J4.4, U1.5 (SIN)
Sout: J5.4, U1.24 (SOUT)
Vcc: C1.2, C18.2, C19.2, C20.2, C21.2, C22.2, C24.1, D1.2 (A), J4.2, J5.6, J6.2, R67.2, R69.1, U1.26 (DCPRG), U1.28 (VCC), U2.4 (V+), U3.4 (V+), U4.4 (V+), U5.4 (V+), U6.4 (V+)
XLAT: J4.6, J5.2, U1.3 (XLAT)
