RepRapLtd/AnalogueNeuralNet/Electronics/LED-shield/LED-shield.kicad_pcb

## KiCad design Electronics/LED-shield/LED-shield.kicad_pcb (2023-09-08)

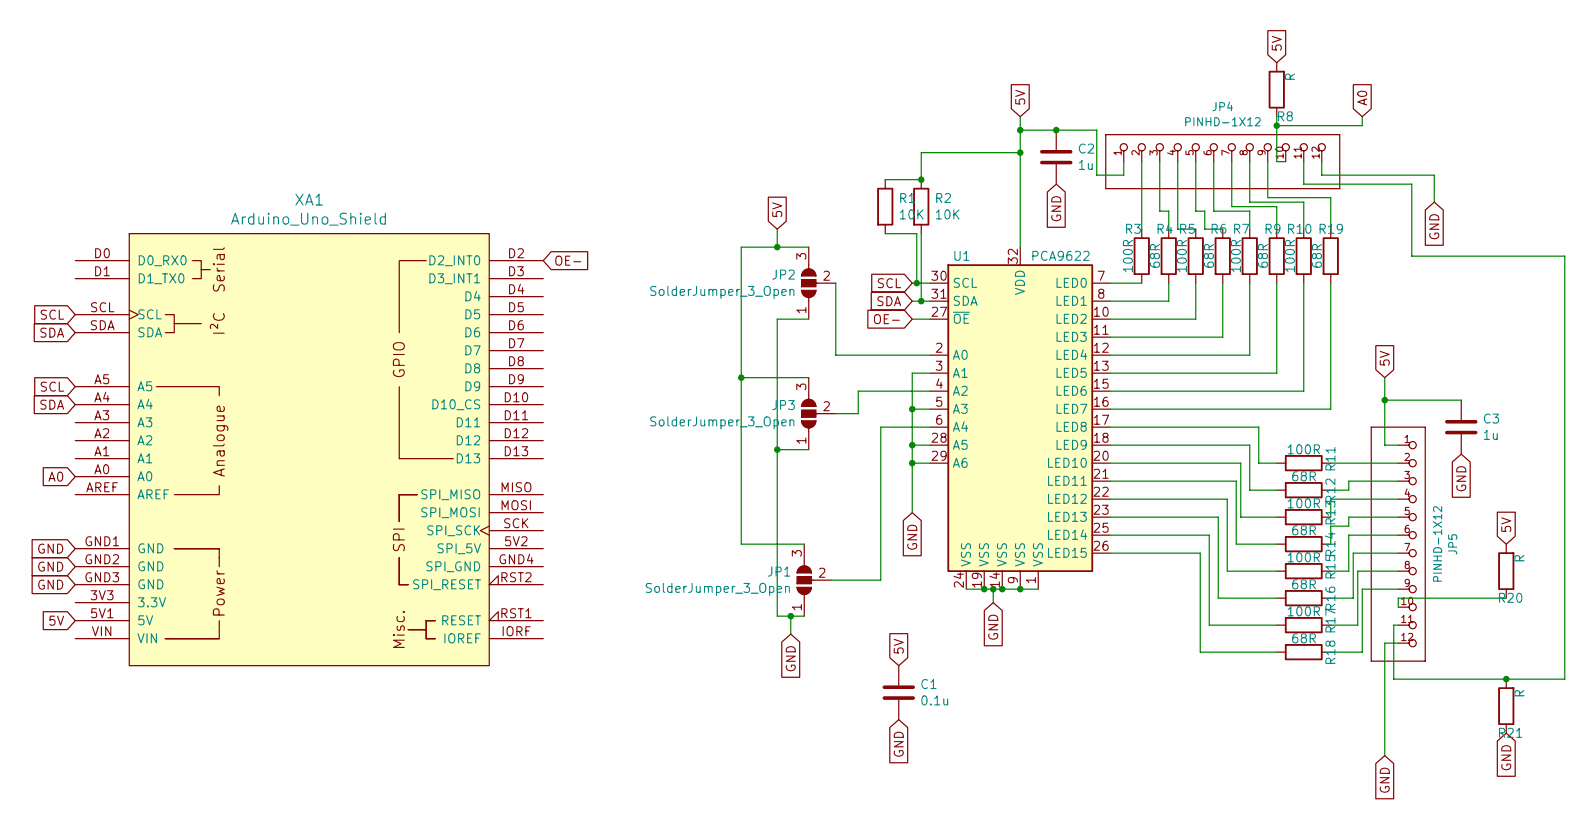
[picture p37: schematic LED-shield.kicad_sch]

Parts:
C1: 0.1u; C_0805_2012Metric_Pad1.15x1.40mm_HandSolder
C2, C3: 1u; C_0805_2012Metric_Pad1.15x1.40mm_HandSolder
JP1, JP2, JP3: SolderJumper_3_Open; SolderJumper-3_P1.3mm_Open_Pad1.0x1.5mm
JP4, JP5: PINHD-1X12; PinHeader_1x12_P2.54mm_Vertical
R1, R2: 10K; R_0805_2012Metric
R3, R5, R7, R10, R11, R13, R15, R17: 100R; R_0805_2012Metric
R4, R6, R9, R12, R14, R16, R18, R19: 68R; R_0805_2012Metric
R8, R20, R21: R; R_0805_2012Metric
U1: PCA9622; TSSOP-32_6.1x11mm_P0.65mm
XA1: Arduino_Uno_Shield

Connections:
5V: C1.1, C2.1, C3.1, JP1.3 (B), JP2.3 (B), JP3.3 (B), JP4.1, JP5.1, R1.1, R2.1, R8.2, R20.2, U1.32 (VDD), XA1.5V1 (5V)
A0: JP4.10, R8.1, XA1.A0
GND: C1.2, C2.2, C3.2, JP1.1 (A), JP2.1 (A), JP3.1 (A), JP4.12, JP5.12, R21.1, U1.1 (VSS), U1.3 (A1), U1.5 (A3), U1.9 (VSS), U1.14 (VSS), U1.19 (VSS), U1.24 (VSS), U1.28 (A5), U1.29 (A6), XA1.GND1 (GND), XA1.GND2 (GND), XA1.GND3 (GND)
unnamed: JP1.2 (C), U1.6 (A4)
unnamed: JP2.2 (C), U1.2 (A0)
unnamed: JP3.2 (C), U1.4 (A2)
unnamed: JP4.2, R3.1
unnamed: JP4.3, R4.1
unnamed: JP4.4, R5.1
unnamed: JP4.5, R6.1
unnamed: JP4.6, R7.1
unnamed: JP4.7, R9.1
unnamed: JP4.8, R10.1
unnamed: JP4.9, R19.1
unnamed: JP4.11, JP5.11, R21.2
unnamed: JP5.2, R11.1
unnamed: JP5.3, R12.1
unnamed: JP5.4, R13.1
unnamed: JP5.5, R14.1
unnamed: JP5.6, R15.1
unnamed: JP5.7, R16.1
unnamed: JP5.8, R17.1
unnamed: JP5.9, R18.1
unnamed: JP5.10, R20.1
unnamed: R3.2, U1.7 (LED0)
unnamed: R4.2, U1.8 (LED1)
unnamed: R5.2, U1.10 (LED2)
unnamed: R6.2, U1.11 (LED3)
unnamed: R7.2, U1.12 (LED4)
unnamed: R9.2, U1.13 (LED5)
unnamed: R10.2, U1.15 (LED6)
unnamed: R11.2, U1.17 (LED8)
unnamed: R12.2, U1.18 (LED9)
unnamed: R13.2, U1.20 (LED10)
unnamed: R14.2, U1.21 (LED11)
unnamed: R15.2, U1.22 (LED12)
unnamed: R16.2, U1.23 (LED13)
unnamed: R17.2, U1.25 (LED14)
unnamed: R18.2, U1.26 (LED15)
unnamed: R19.2, U1.16 (LED7)
OE-: U1.27 (~OE), XA1.D2 (D2_INT0)
SCL: R1.2, U1.30 (SCL), XA1.A5, XA1.SCL
SDA: R2.2, U1.31 (SDA), XA1.A4, XA1.SDA

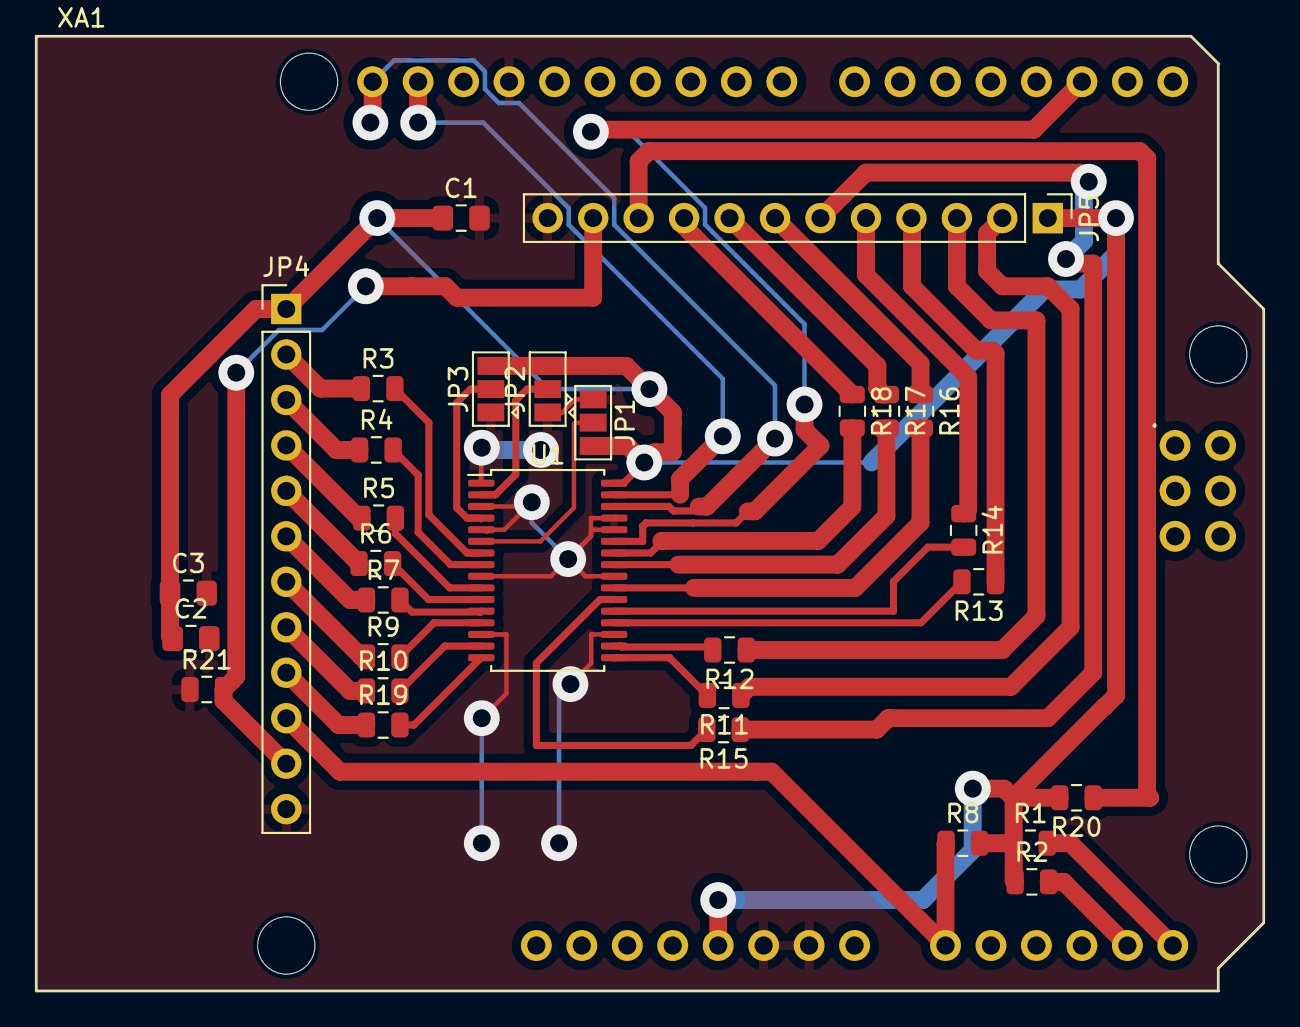
[picture p38: board LED-shield.kicad_pcb from above]

Board: 2 copper layers, 68.6 x 53.3 mm, 31 parts (0 on the bottom side), 43 nets.
