RepRapLtd/AnalogueNeuralNet/Electronics/LED-shield/Direct-drive-LEDs/Direct-drive-LEDs.kicad_pcb

## KiCad design Electronics/LED-shield/Direct-drive-LEDs/Direct-drive-LEDs.kicad_pcb (2023-09-08)

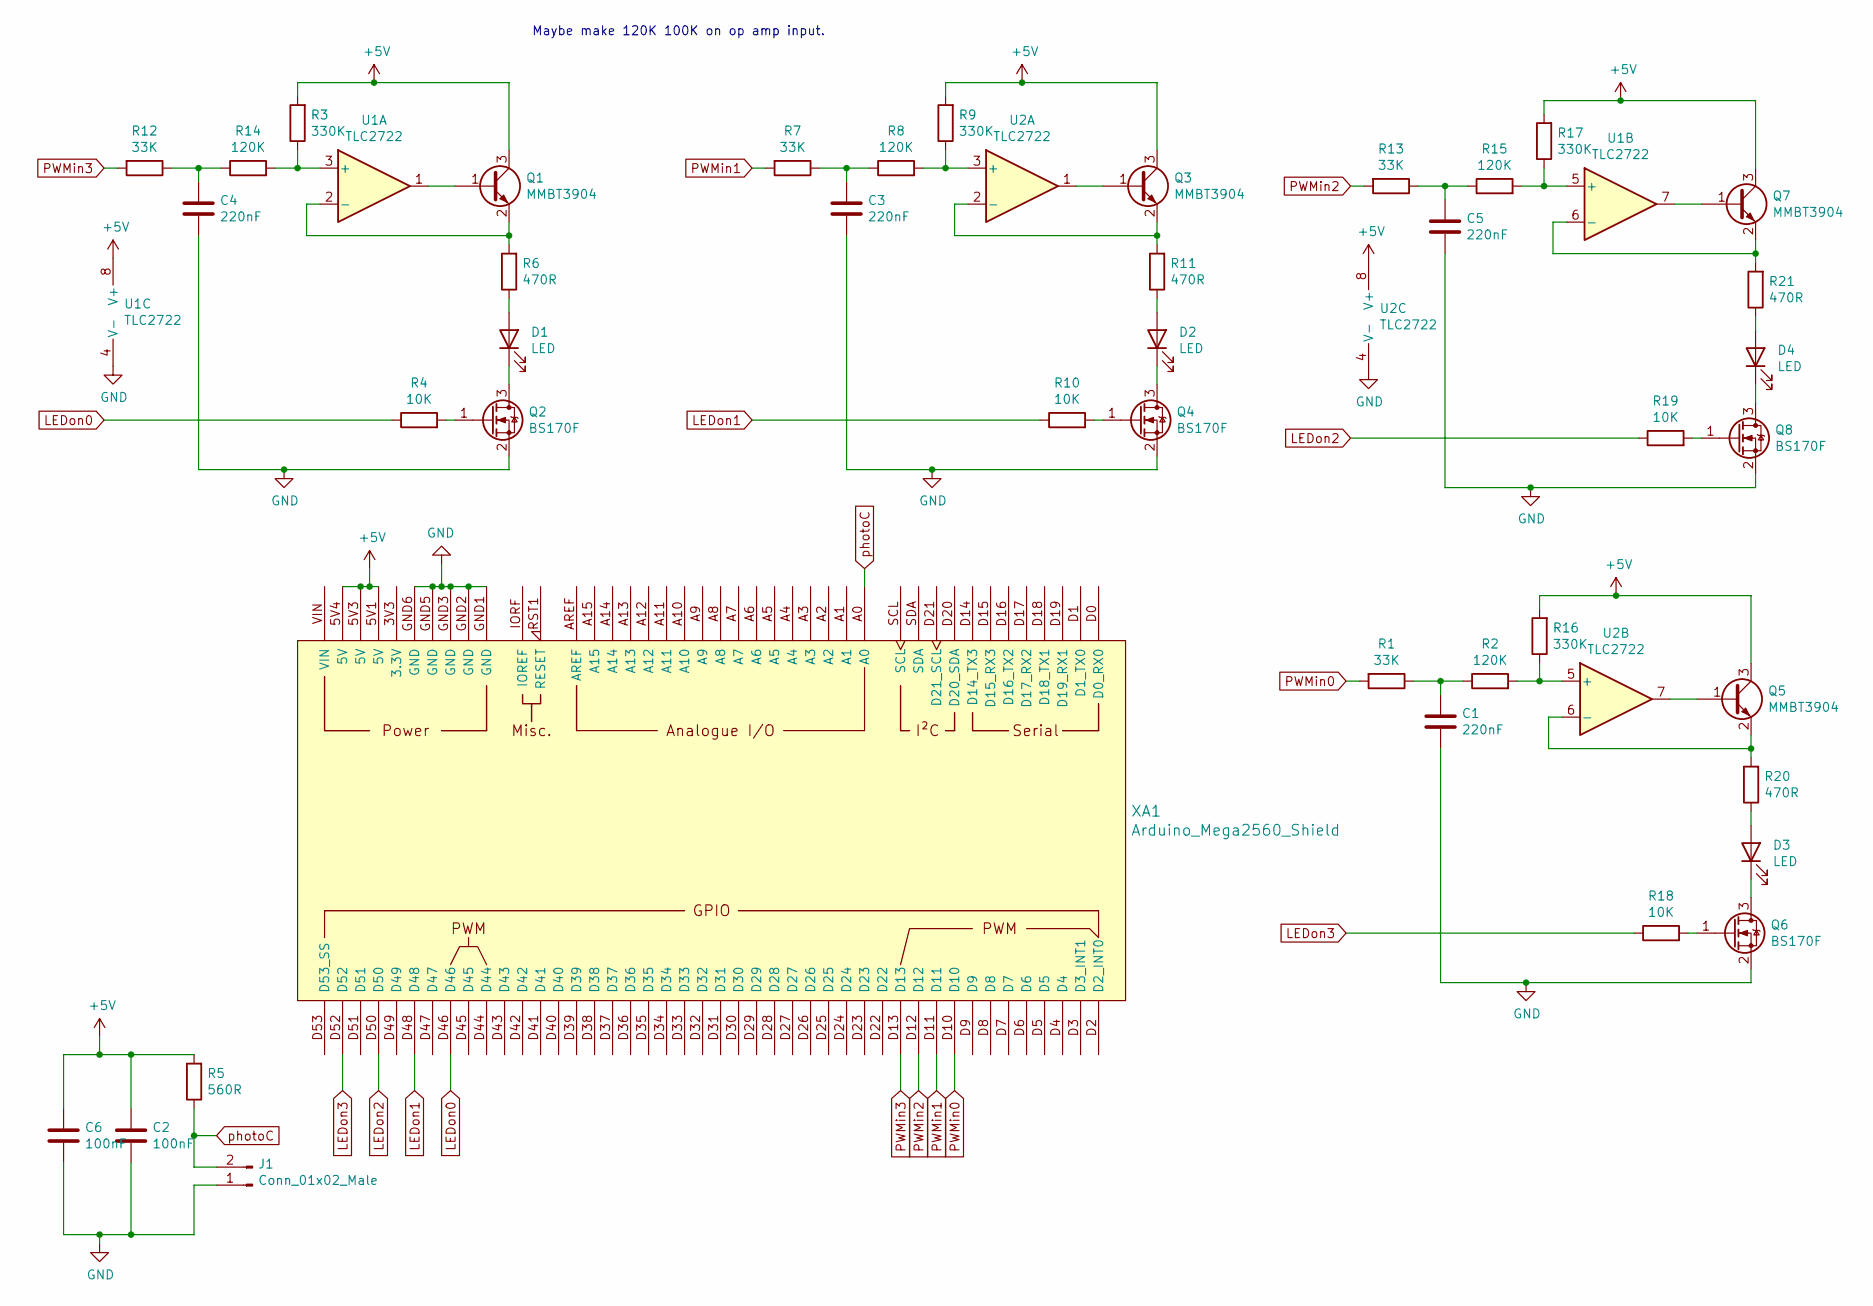
[picture p39: schematic Direct-drive-LEDs.kicad_sch]

Parts:
C1, C3, C4, C5: 220nF; C_0805_2012Metric_Pad1.15x1.40mm_HandSolder
C2, C6: 100nF; C_0805_2012Metric_Pad1.15x1.40mm_HandSolder
D1, D2, D3, D4: LED; LED_D3.0mm
J1: Conn_01x02_Male; PinHeader_1x02_P2.54mm_Vertical
Q1, Q3, Q5, Q7: MMBT3904; SOT-23
Q2, Q4, Q6, Q8: BS170F; SOT-23
R1, R7, R12, R13: 33K; R_0805_2012Metric
R2, R8, R14, R15: 120K; R_0805_2012Metric
R3, R9, R16, R17: 330K; R_0805_2012Metric
R4, R10, R18, R19: 10K; R_0805_2012Metric
R5: 560R; R_0805_2012Metric
R6, R11, R20, R21: 470R; R_0805_2012Metric
U1, U2: TLC2722; SOIC-8_3.9x4.9mm_P1.27mm
XA1: Arduino_Mega2560_Shield

Connections:
+5V: C2.1, C6.1, Q1.3 (C), Q3.3 (C), Q5.3 (C), Q7.3 (C), R3.2, R5.2, R9.2, R16.2, R17.2, U1.8 (V+), U2.8 (V+), XA1.5V1 (5V), XA1.5V3 (5V), XA1.5V4 (5V)
GND: C1.2, C2.2, C3.2, C4.2, C5.2, C6.2, J1.1, Q2.2 (S), Q4.2 (S), Q6.2 (S), Q8.2 (S), U1.4 (V-), U2.4 (V-), XA1.GND1 (GND), XA1.GND2 (GND), XA1.GND3 (GND), XA1.GND5 (GND), XA1.GND6 (GND)
LEDon0: R4.1, XA1.D46
LEDon1: R10.1, XA1.D48
LEDon2: R19.1, XA1.D50
LEDon3: R18.1, XA1.D52
unnamed: C1.1, R1.1, R2.1
unnamed: C3.1, R7.1, R8.1
unnamed: C4.1, R12.1, R14.1
unnamed: C5.1, R13.1, R15.1
unnamed: D1.1 (K), Q2.3 (D)
unnamed: D1.2 (A), R6.1
unnamed: D2.1 (K), Q4.3 (D)
unnamed: D2.2 (A), R11.1
unnamed: D3.1 (K), Q6.3 (D)
unnamed: D3.2 (A), R20.1
unnamed: D4.1 (K), Q8.3 (D)
unnamed: D4.2 (A), R21.1
unnamed: Q1.1 (B), U1.1
unnamed: Q1.2 (E), R6.2, U1.2 (-)
unnamed: Q2.1 (G), R4.2
unnamed: Q3.1 (B), U2.1
unnamed: Q3.2 (E), R11.2, U2.2 (-)
unnamed: Q4.1 (G), R10.2
unnamed: Q5.1 (B), U2.7
unnamed: Q5.2 (E), R20.2, U2.6 (-)
unnamed: Q6.1 (G), R18.2
unnamed: Q7.1 (B), U1.7
unnamed: Q7.2 (E), R21.2, U1.6 (-)
unnamed: Q8.1 (G), R19.2
unnamed: R8.2, R9.1, U2.3 (+)
unnamed: R3.1, R14.2, U1.3 (+)
unnamed: R15.2, R17.1, U1.5 (+)
unnamed: R2.2, R16.1, U2.5 (+)
PWMin0: R1.2, XA1.D10
PWMin1: R7.2, XA1.D11
PWMin2: R13.2, XA1.D12
PWMin3: R12.2, XA1.D13
photoC: J1.2, R5.1, XA1.A0

Notes on the sheet:
Maybe make 120K 100K on op amp input.

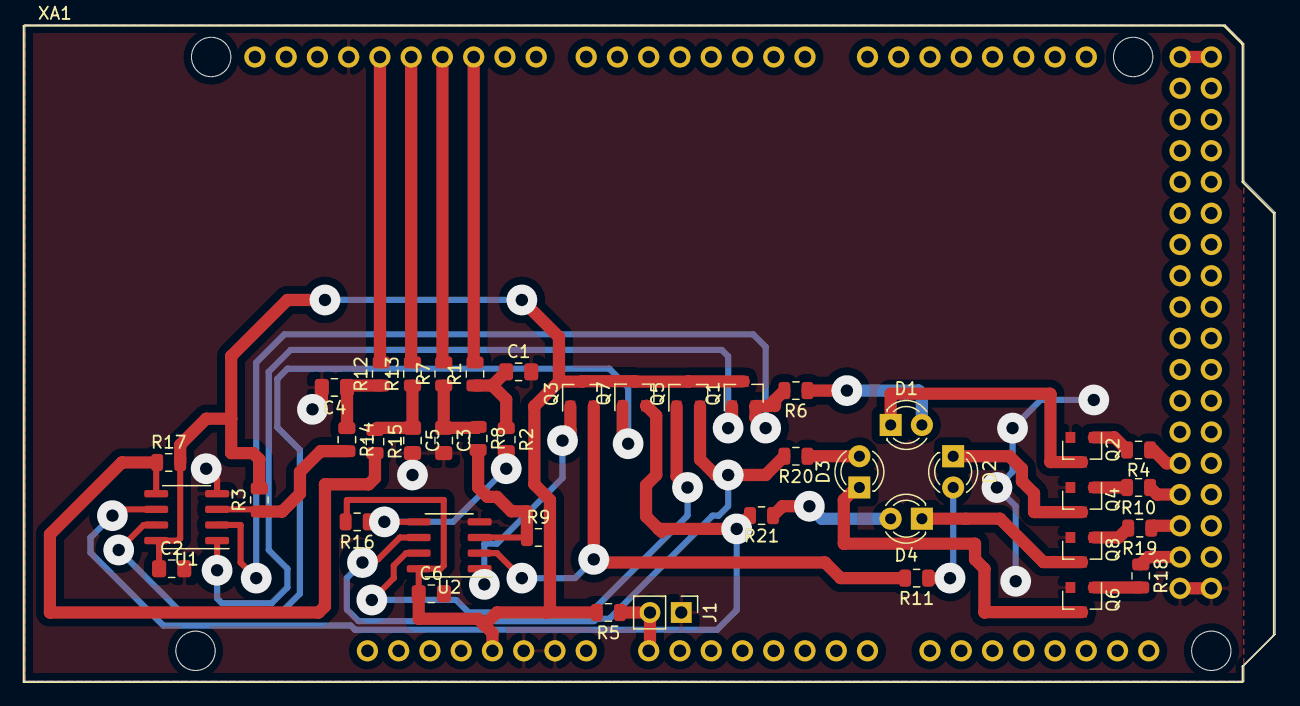
[picture p40: board Direct-drive-LEDs.kicad_pcb from above]

Board: 2 copper layers, 101.6 x 53.3 mm, 43 parts (0 on the bottom side), 39 nets.
