RepRapLtd/AnalogueNeuralNet/Electronics/LED-shield/Direct-drive-LEDs/GERBER/GCode/front.g

; pcb2gcode 2.0.0 
; Software-independent Gcode 

G94 ; Millimeters per minute feed rate. 
G21 ; Units == Millimeters. 

G90 ; Absolute coordinates. 
;G1 F3000 S10000 ; RPM spindle speed. 
G1 F300 F600.00000 ; Feedrate. 


G1 F3000 Z3.00000 ;Retract to tool change height
;T0
;M5      ;Spindle stop.
;G04 P1.00000 ;Wait for spindle to stop
;MSG, Change tool bit to mill diameter 0.12000mm
;M6      ;Tool change.
;M0      ;Temporary machine stop.
;M3 ; Spindle on clockwise. 
;G04 P1.00000 ;Wait for spindle to get up to speed
;G04 P0 ; dwell for no time -- G64 should not smooth over this point 
G1 F3000 Z3.00000 ; retract 

G1 F3000 X17.91372 Y50.87274 ; rapid move to begin. 
G1 F300 F300.00000
G1 F300 Z-0.07000
;G04 P0 ; dwell for no time -- G64 should not smooth over this point 
G1 F300 F600.00000
G1 F300 X17.91372 Y50.87274
G1 F300 X17.93356 Y50.68699
G1 F300 X17.99322 Y50.50334
G1 F300 X18.08637 Y50.34139
G1 F300 X18.21898 Y50.19265
G1 F300 X18.38078 Y50.07629
G1 F300 X18.55157 Y50.00063
G1 F300 X18.73424 Y49.96146
G1 F300 X18.92726 Y49.96014
G1 F300 X19.12241 Y50.00063
G1 F300 X19.29320 Y50.07629
G1 F300 X19.45499 Y50.19265
G1 F300 X19.58024 Y50.33126
G1 F300 X19.68075 Y50.50334
G1 F300 X19.73879 Y50.68092
G1 F300 X19.76025 Y50.88528
G1 F300 X19.74041 Y51.07103
G1 F300 X19.68075 Y51.25468
G1 F300 X19.58761 Y51.41663
G1 F300 X19.45499 Y51.56537
G1 F300 X19.29320 Y51.68173
G1 F300 X19.12241 Y51.75742
G1 F300 X18.93973 Y51.79656
G1 F300 X18.74672 Y51.79788
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
G1 F300 X84.65413 Y12.29072
G1 F300 X84.65298 Y12.14302
G1 F300 X84.31417 Y12.14302
G1 F300 X84.26350 Y12.19367
G1 F300 X84.27143 Y12.36684
G1 F300 X84.33868 Y12.52913
G1 F300 X84.44478 Y12.64556
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
;G04 P0 ; dwell for no time -- G64 should not smooth over this point 
G1 F3000 Z3.00000 ; retract
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
