RepRapLtd/AnalogueNeuralNet/(commit log)

2020-10-21 First commit.
    [one-synapse.kicad_pcb, one-synapse.sch, response.csv, response.ods, single-synapse.FCStd, synapse.stl]
2020-10-22 Added a few documents and images...
    [Synapse 2 0.1.FCStd, pwm-test.csv, pwm-test.ods, response.ods, single-synapse.FCStd]
2020-10-22 Tweaking designs...
    [Light Input 0.1.FCStd, Multi Input Synapse 0.1.FCStd, Multi Input Synapse 0.1.stl, Synapse 2 0.1.FCStd, Synapse 2 0.1.stl, light-input.stl]
2020-11-03 Design change update
    [Light Input 0.2.FCStd, Light Input 0.2.stl, Synapse 2 Small LED 0.1.FCStd, Synapse 2 Small LED 0.1.stl, Synapse 2 Small LED 0.2.FCStd, Synapse 2 Small LED 0.2.stl]
2020-11-05 Start work on simulator.
    [integrated-neuron-0.1.FCStd]
2020-11-06 First design of complete 4-input neuron.
    [integrated-neuron-0.1.FCStd, integrated-neuron-fibres.stl, integrated-neuron-input.stl, integrated-neuron-output.stl]
2020-11-06 Correcting STL orientations.
    [integrated-neuron-0.1.FCStd, integrated-neuron-fibres.stl, integrated-neuron-output.stl]
2020-11-11 I2C LED PCB. W.I.P.
    [LED-shield.kicad_pcb, LED-shield.sch]
2020-11-20 Fibre polishing disc and painting jig added. Simulator WIP.
    [Painting Jig 0.1.FCStd, Painting Jig 0.1.stl, Sanding Disc 0.1.FCStd, Sanding Disc 0.1.stl]
2020-11-24 First half-neuron complete and wired into UNO. Test program nearly complete.
    [Painting Jig 0.1.FCStd, Painting Jig 0.1.g, Painting Jig 0.2 (Fisher).FCStd, Painting Jig 0.2.g, Painting Jig 0.2.stl, Sanding Disc 0.1.FCStd]
2020-11-25 Calibration test written. Simulator WIP.
2020-11-25 Expt. results.
    [half-neuron-calibration.csv]
2020-11-26 Putting in back propagation. WIP
    [Painting Jig 0.1 (Fisher).FCStd, Painting Jig 0.1 (ultimaker).FCStd, Painting Jig 0.1.g, Painting Jig 0.2 (ultimaker).FCStd, Painting Jig 0.2(Ultimaker).stl, Painting Jig 0.2.g, Painting Jig 0.2.stl, half-neuron-calibration.ods]
2020-11-27 Arduino code to train a single neuron. WIP
    [neuron-diagram.dxf]
2020-11-28 Much improved error function in teaching program. Needs tweaking, but pretty close.
    [half-neuron.ino, odd-even-2.ino]
2020-11-28 Homing in on training... WIP
2020-11-30 Keping up to date...
    [scan.csv]
2020-11-30 Modelling first neuron in the Python simulator.
    [half-neuron-calibration.ods, simulator-half-neuron-calibration.csv]
2020-12-01 More work on the simulator...
    [half-neuron-calibration.ods, simulator-half-neuron-calibration.csv]
2020-12-02 Added space sampling to the simulator optimisation.
    [half-neuron-calibration.ods, simulator-half-neuron-calibration.csv]
2020-12-02 More simulation WIP. Adding random explore to the Arduino program.
2020-12-15 WIP on direct modulated LEDs.
    [Crude Image Sensor Array 0.1.FCStd, Crude Image Sensor Array 0.1.stl, Direct-drive-LEDs.kicad_pcb, Direct-drive-LEDs.sch, Driven-LED-calibration.csv, Driven-LED-calibration.ods]
2020-12-16 Direct drive LED circuit developing and testing.
    [Direct-drive-LEDs.sch, Driven-LED-calibration.csv, Driven-LED-calibration.ods, op-amp-bias.ods]
2020-12-30 First pure optronic half-neuron complete and tested.
    [Direct-drive-LEDs.sch]
2020-12-31 PCB for 4 LEDs.
    [Direct-drive-LEDs.kicad_pcb, Direct-drive-LEDs.sch]
2021-01-01 Arduino MEGA shield for half-neuron WIP.
    [Direct-drive-LEDs.kicad_pcb, Direct-drive-LEDs.sch]
2021-01-03 Minor PCB mods WIP.
    [Direct-drive-LEDs.kicad_pcb, Direct-drive-LEDs.sch]
2021-01-04 More PCB WIP.
    [Direct-drive-LEDs.kicad_pcb, Direct-drive-LEDs.sch]
2021-01-05 More PCB WIP...
    [Direct-drive-LEDs.kicad_pcb, Direct-drive-LEDs.sch]
2021-01-06 First finished PCB.
    [Direct-drive-LEDs.kicad_pcb, Direct-drive-LEDs.sch]
2021-01-26 PCB GERBERS.
    [Direct-drive-LEDs.kicad_pcb, Direct-drive-LEDs.sch, drill.g, front.g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]
2021-01-28 Now with better resistance values...
    [Direct-drive-LEDs.kicad_pcb, Direct-drive-LEDs.sch, full-neuron-calibration-a.csv, full-neuron-calibration-b.csv, full-neuron-calibration-c.csv, full-neuron-calibration-d.csv, full-neuron-calibration.csv, full-neuron-calibration.ods]
2021-03-05 Starting work on using Pi screen as fibre input.
    [laser-rectangle-100x20.dxf]
2021-03-25 Sally's shield design.
    [LED-shield.kicad_pcb, LED-shield.sch, laser-dot-test.dxf]
2023-09-08 WIP on pure electronic version
    [Direct-drive-LEDs.kicad_pcb, Direct-drive-LEDs.kicad_sch, LED-shield.kicad_pcb, LED-shield.kicad_sch, MCP604-driving-LED.ods, one-synapse.kicad_pcb, one-synapse.kicad_sch]
2023-09-13 More on fully electronic version
    [sum-diff-calibration.ods]
2023-09-22 Start work on electronic synapse
    [one-synapse-electronic.kicad_pcb, one-synapse-electronic.kicad_sch, one-synapse.kicad_pcb, one-synapse.kicad_sch, one-synapse.sch]
2023-09-23 Initial design for analogue electronic synapse
    [one-synapse-electronic.kicad_sch, pwm.kicad_sch, sum-diff.kicad_sch, synapse-inputs.kicad_sch]
2023-09-27 WIP. Added combiner i/o.
    [one-synapse-electronic.kicad_pcb, sum-diff.kicad_sch]
2023-10-23 PCB WIP
    [one-synapse-electronic.kicad_pcb]
2023-11-03 The first(!) final PCB design...
    [one-synapse-electronic.kicad_pcb]
2023-11-03 2nd final PCB design...
    [one-synapse-electronic.kicad_pcb]
2024-03-20 Starting work on the D to A version.
    [one-synapse-electronic-B_Cu.gbr, one-synapse-electronic-B_Mask.gbr, one-synapse-electronic-B_Paste.gbr, one-synapse-electronic-B_Silkscreen.gbr, one-synapse-electronic-Edge_Cuts.gbr, one-synapse-electronic-F_Cu.gbr, one-synapse-electronic-F_Mask.gbr, one-synapse-electronic-F_Paste.gbr]
2024-03-21 Arduino i2c to digital program.
2024-04-04 More docs and I2C test prog.
2024-04-09 GPT4/Skidl experiments.
    [skidl-experiment.kicad_pcb, skidl-experiment.kicad_sch]
2024-04-11 Switching to SPI chip. Not working yet...
    [spi-controller.ino, spi_controller-2.ino]
2024-05-06 Using Arduino to measure output voltages.
2024-05-06 Adding diagrams and pix
    [axon-synapse-conn.kicad_sch, crosspoint.kicad_pcb, crosspoint.kicad_sch, synapse-axon-conn.kicad_sch]
2024-05-07 Add images from svgs
    [axon-synapse-conn.kicad_sch, crosspoint.kicad_sch, one-neuron.kicad_sch, one-synapse.kicad_sch, synapse-axon-conn.kicad_sch]
2024-05-07 Switch to Kramdown
2024-05-09 Now with added spelling...
    [crosspoint.kicad_sch, scratchpad.kicad_sch]
2024-05-17 Started design of crosspoint PCB.
    [crosspoint-switches.kicad_pcb, crosspoint-switches.kicad_sch]
2024-05-20 First crosspoint block PCB design.
    [crosspoint-switches.kicad_pcb, crosspoint-switches.kicad_sch]
2024-05-21 Removed ring road on PCB
    [crosspoint-switches-B_Cu.gbr, crosspoint-switches-B_Mask.gbr, crosspoint-switches-B_Silkscreen.gbr, crosspoint-switches-Edge_Cuts.gbr, crosspoint-switches-F_Cu.gbr, crosspoint-switches-F_Mask.gbr, crosspoint-switches-F_Silkscreen.gbr, crosspoint-switches-NPTH.drl]
2024-05-21 Tidying after inspecting GERBERs
    [crosspoint-switches-B_Cu.gbr, crosspoint-switches-B_Mask.gbr, crosspoint-switches-B_Silkscreen.gbr, crosspoint-switches-Edge_Cuts.gbr, crosspoint-switches-F_Cu.gbr, crosspoint-switches-F_Mask.gbr, crosspoint-switches-F_Silkscreen.gbr, crosspoint-switches-NPTH.drl]
2024-05-27 Started crosspoint Python simulation project.
    [crosspoint-switches-NPTH.drl]
